yoganandasp15/Spatial-accoustic-project/hardware_photos/components_closeup_classic_esp32.jpg

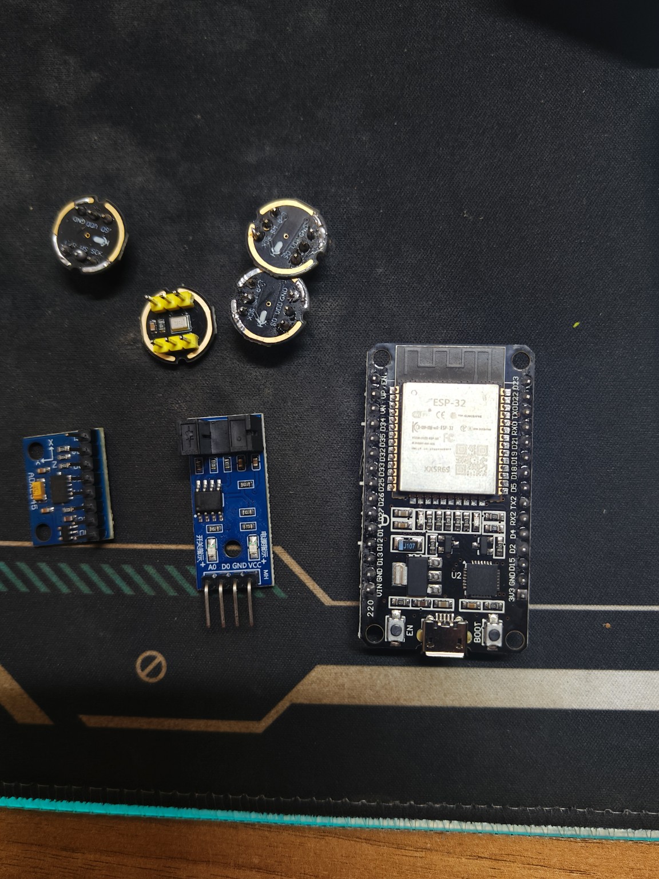
hardware_photos/components_closeup_classic_esp32.jpg
