yoganandasp15/Spatial-accoustic-project/hardware_photos/components_overview.jpg

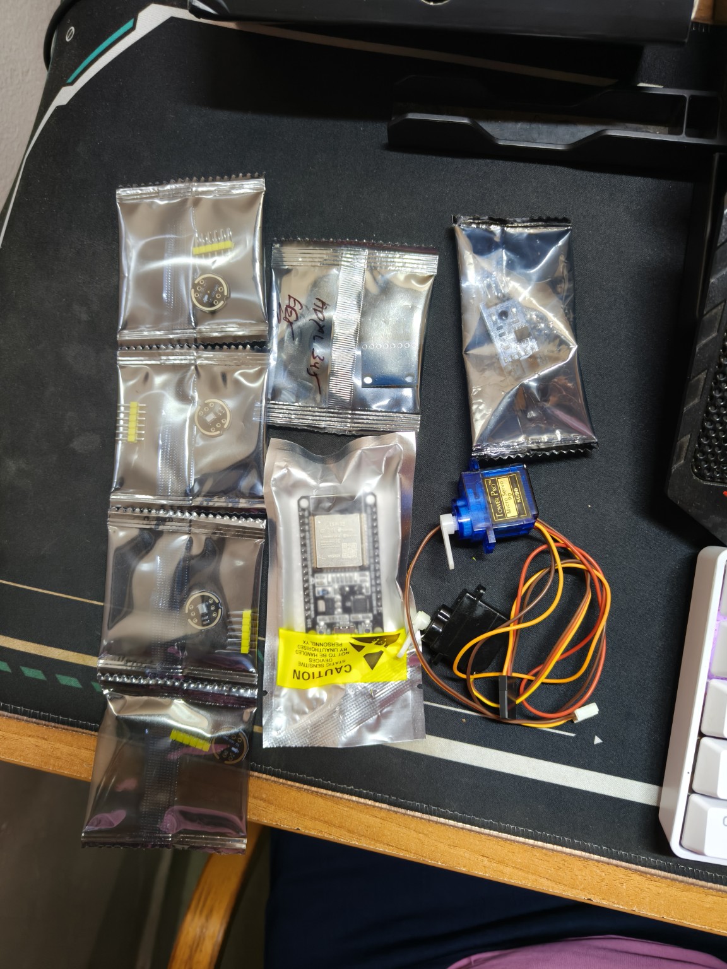
hardware_photos/components_overview.jpg
