yoganandasp15/Spatial-accoustic-project/docs/daily_logs/2026-11-07_minor_project_reconciliation.md

# Engineering Daily Log — 7 November 2026

**Milestone:** ECE Minor Project Evaluation & AI Peer Review Reconciliation  
**Engineers:** Yogi & Antigravity CLI  

---

## 1. Summary of Activities
1. **GitHub Repository Inspection & Audit:**
   - Completed initial repository staging and push to `https://github.com/yoganandasp15/Spatial-accoustic-project.git`.
   - Ingested external AI peer review feedback from ChatGPT via connected repository integration.
   - Audited all 6 critical points raised by ChatGPT across firmware, GUI, and academic documentation.
2. **Firmware Alignment (`ESP32_Spatial_Acoustic_Radar_Firmware.ino`):**
   - Corrected audio sample bit-shift from `>> 14` to `>> 16` for standard MSB-aligned signed 16-bit PCM unpacking.
   - Documented hardware clocking invariants: shared SCK (GPIO 18) and WS (GPIO 21) guarantee 0 PPM sampling frequency drift between I2S0 (Master) and I2S1 (Slave).
   - Clarified DMA buffer block alignment within 128-frame DMA blocks.
3. **GUI Application Enhancements (`spatial_acoustic_radar_pro.py`):**
   - Implemented dynamic **Evidence Mode Tag** in HUD and main figure banner (`[MODE: LIVE 4-MIC ULA PHYSICAL HARDWARE (COM8)]`, `[MODE: SYNTHETIC 4-CH ARRAY SIMULATION]`, `[MODE: LAPTOP INTERNAL MIC DEMO]`).
   - Refined 2D Heatmap title to explicitly reflect 1D ULA Direction of Arrival (DOA bearing $\theta$) radial backprojection.
   - Standardized ISO 10816 labeling to "ISO 10816-Inspired Dynamic Vibration Index (g)" across all classifier outputs and telemetry text.
4. **Academic Documentation & Report Refinements:**
   - Updated `README.md`, `docs/PROJECT_STATUS.md`, `docs/HARDWARE_STATUS.md`, and `MINOR_PROJECT_FINAL_REPORT.md`.
   - Established 4 rigorous academic evidence tiers:
     * Tier 1: Machine fault ground truth (MAFAULDA 10g unbalance $1\times$ order surge & CWRU bearing dataset).
     * Tier 2: Super-resolution acoustic localization simulation proof ($0.34^\circ$ median error across 25 off-grid test points).
     * Tier 3: Classic ESP32 physical embedded prototype (11,025 Hz 4-ch DMA streaming on COM8 @ 921,600 baud).
     * Tier 4: Live interactive multimodal GUI with Golden Baseline differential engine.
   - Created `docs/reviews/chatgpt/2026-11-07_chatgpt_audit_and_reconciliation.md`.

---

## 2. Verification Results
* `py_compile` on `spatial_acoustic_radar_pro.py`: **Exit code 0 (Pass)**.
* Git repository status: All changes staged and tracked cleanly.
