yoganandasp15/Spatial-accoustic-project/docs/evidence/gui_v6_acoustic_disturbance_rejection.png

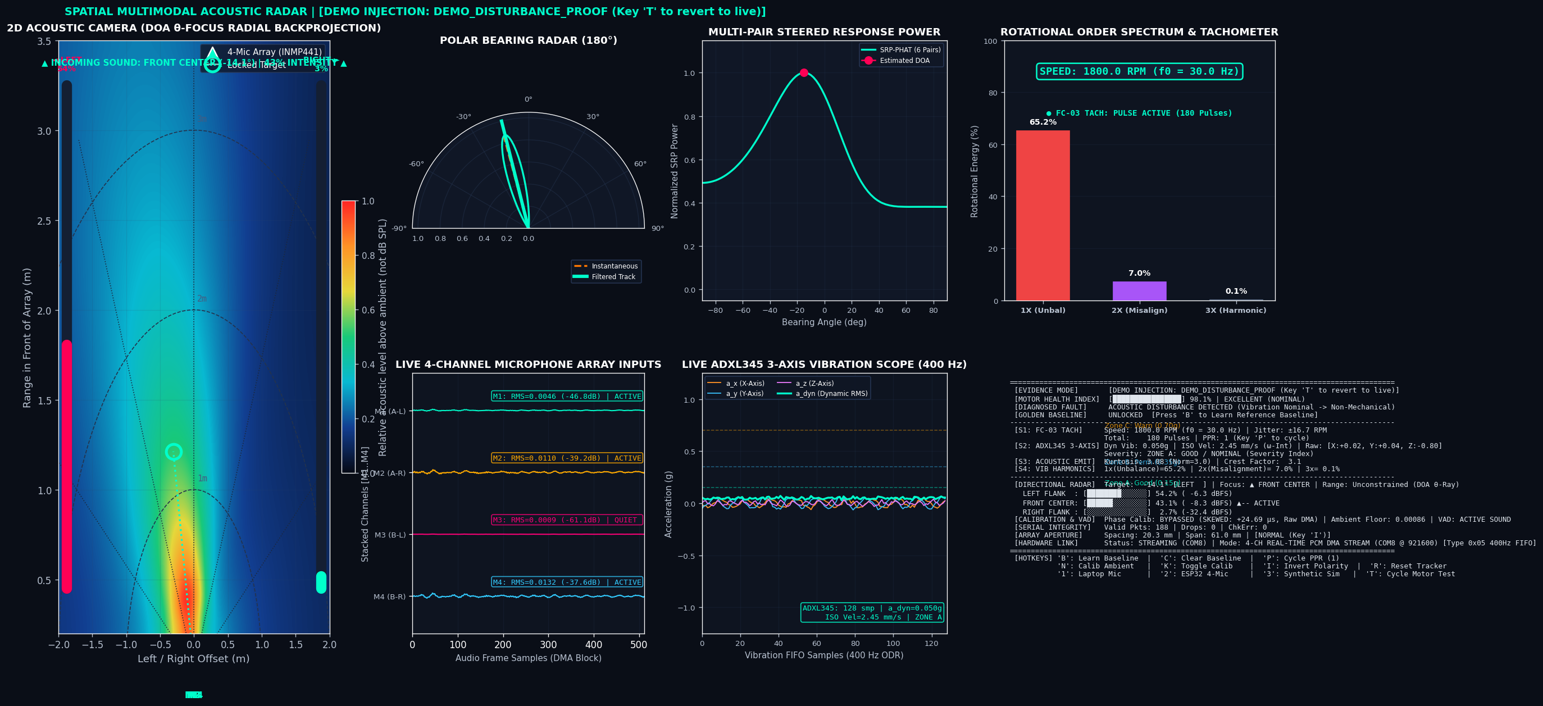
docs/evidence/gui_v6_acoustic_disturbance_rejection.png
