yoganandasp15/Spatial-accoustic-project/docs/evidence/gui_v6_healthy_motor_showcase.png

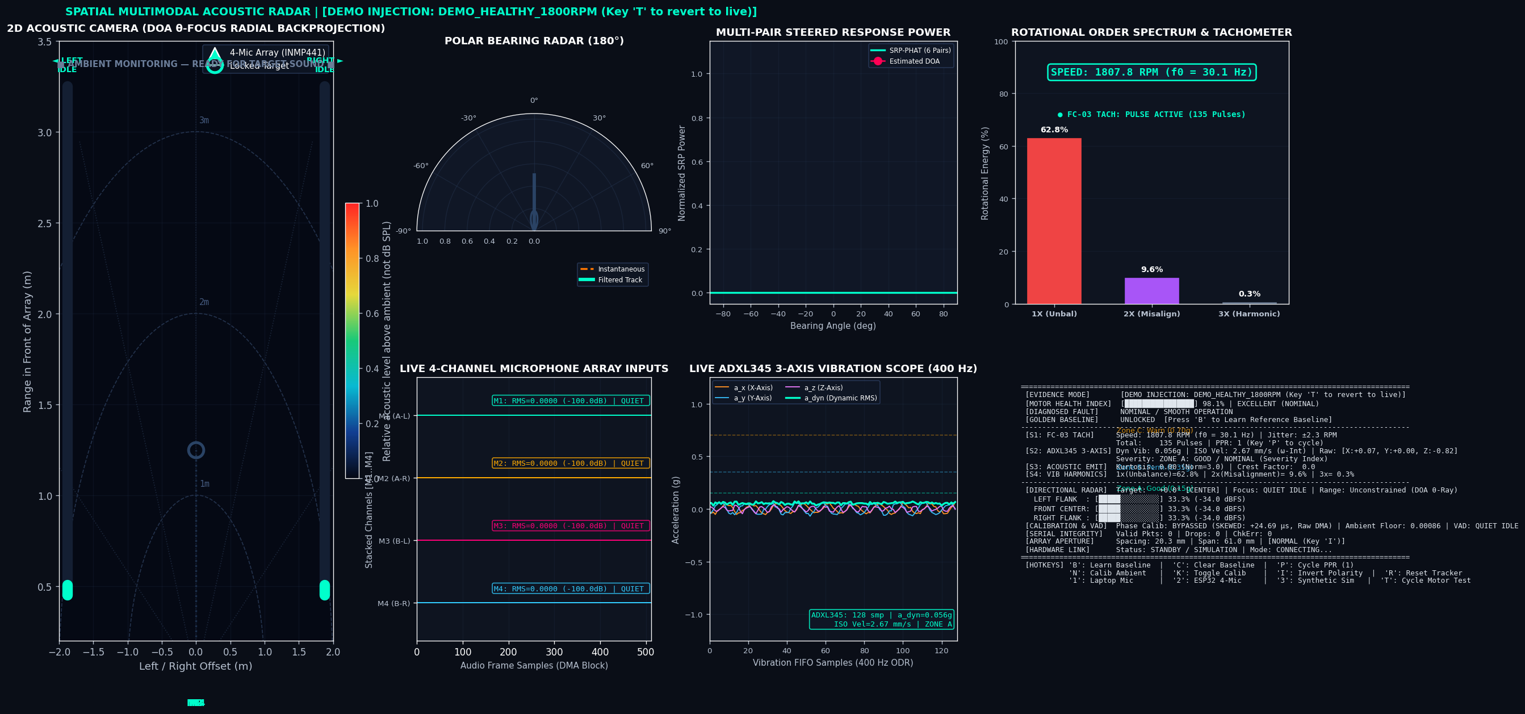
docs/evidence/gui_v6_healthy_motor_showcase.png
