yoganandasp15/Spatial-accoustic-project/docs/evidence/gui_v6_mass_unbalance_showcase.png

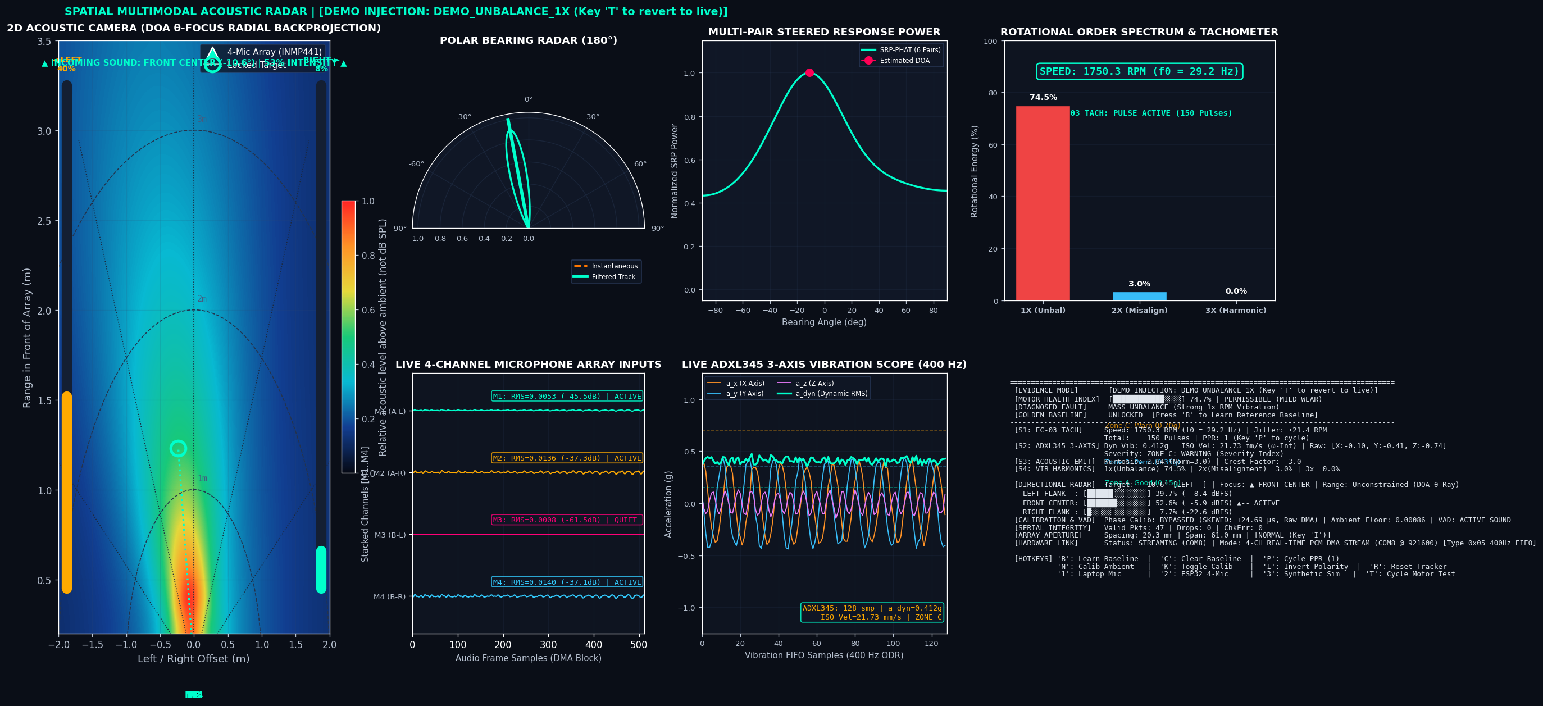
docs/evidence/gui_v6_mass_unbalance_showcase.png
