yoganandasp15/Spatial-accoustic-project/stage2_acoustic_localization/evidence/dual_i2s_phase_skew_audit.png

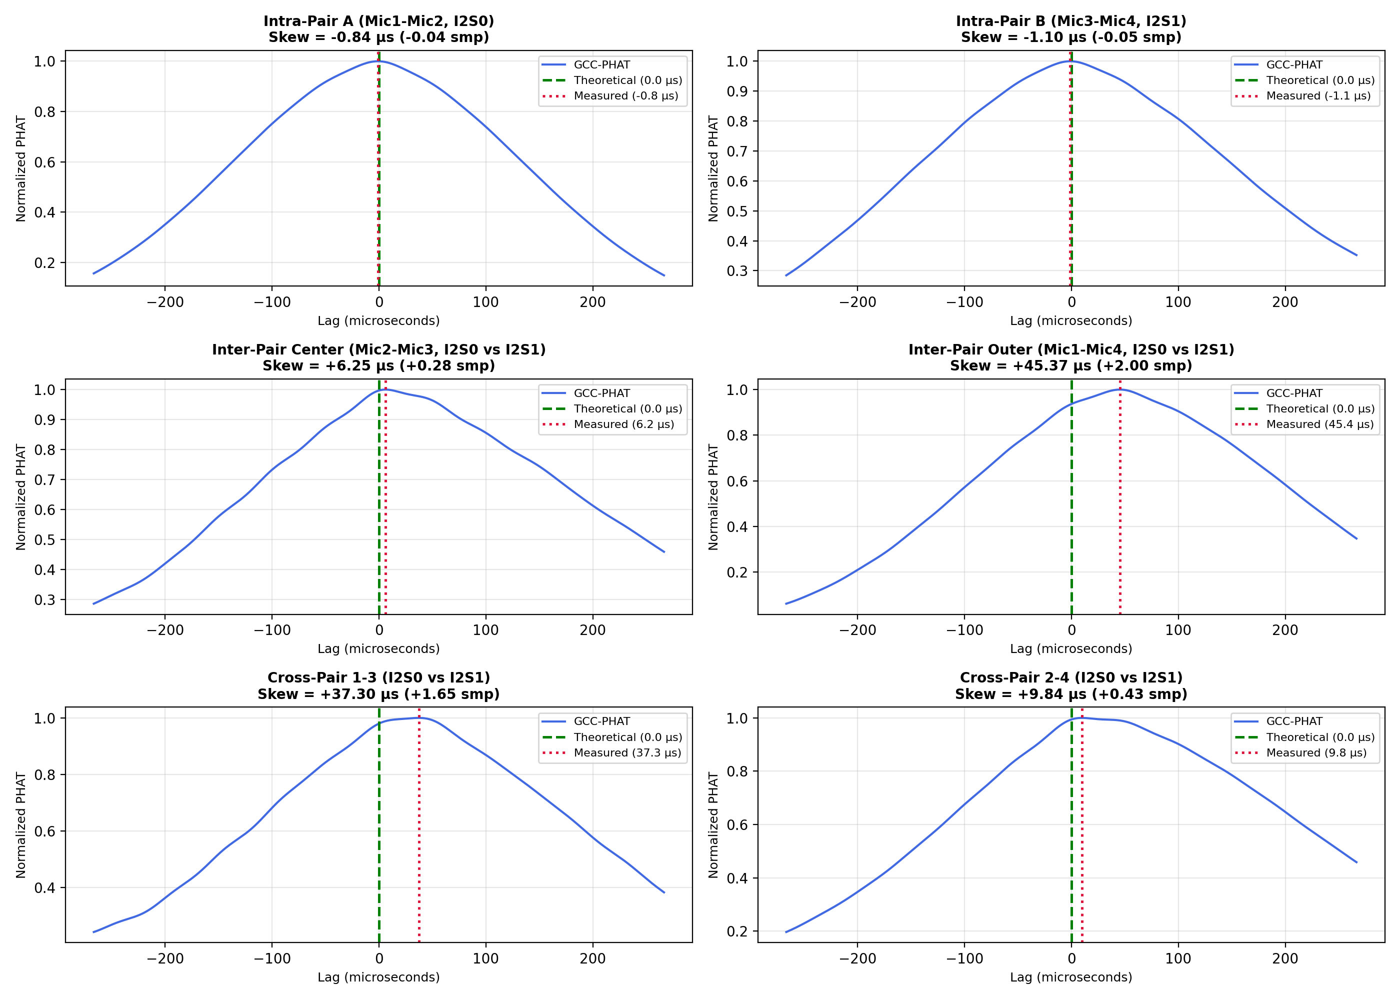
stage2_acoustic_localization/evidence/dual_i2s_phase_skew_audit.png
