yoganandasp15/Spatial-accoustic-project/stage2_acoustic_localization/evidence/stage2/stage2_srp_heatmaps_sample.png

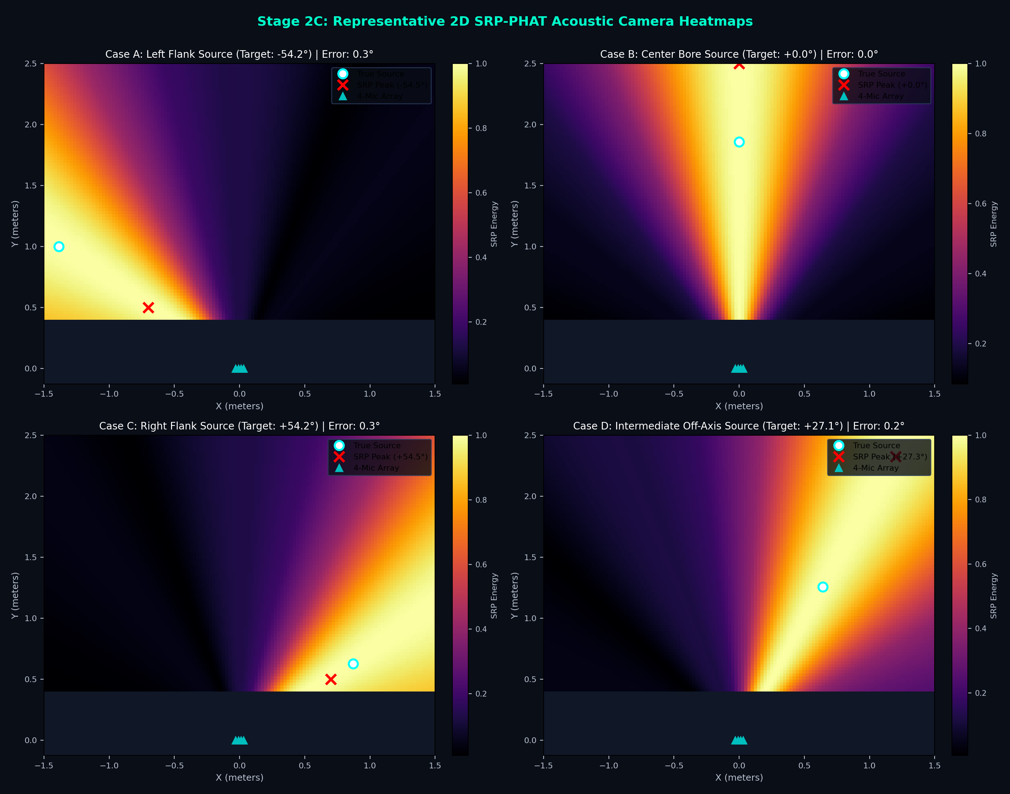
stage2_acoustic_localization/evidence/stage2/stage2_srp_heatmaps_sample.png
