yoganandasp15/Spatial-accoustic-project/stage4_realtime_fusion_radar/evidence/offline_multimodal_diagnostic_report.png

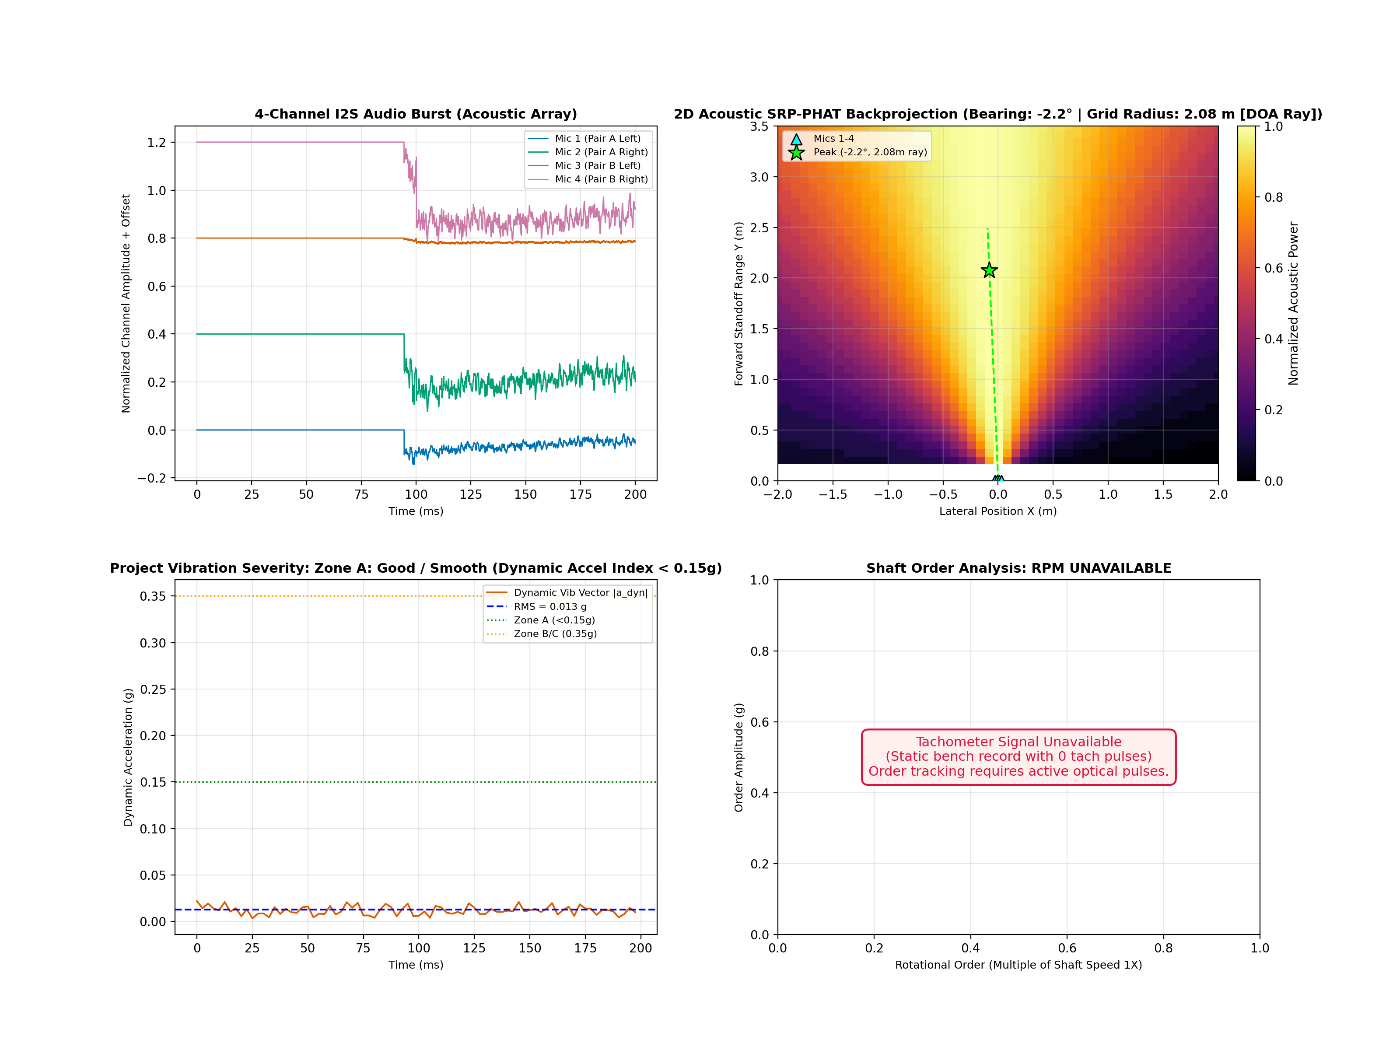
stage4_realtime_fusion_radar/evidence/offline_multimodal_diagnostic_report.png
