yoganandasp15/Spatial-accoustic-project/stage1_vibration_and_tachometer/evidence/order_tracking_spectrum.png

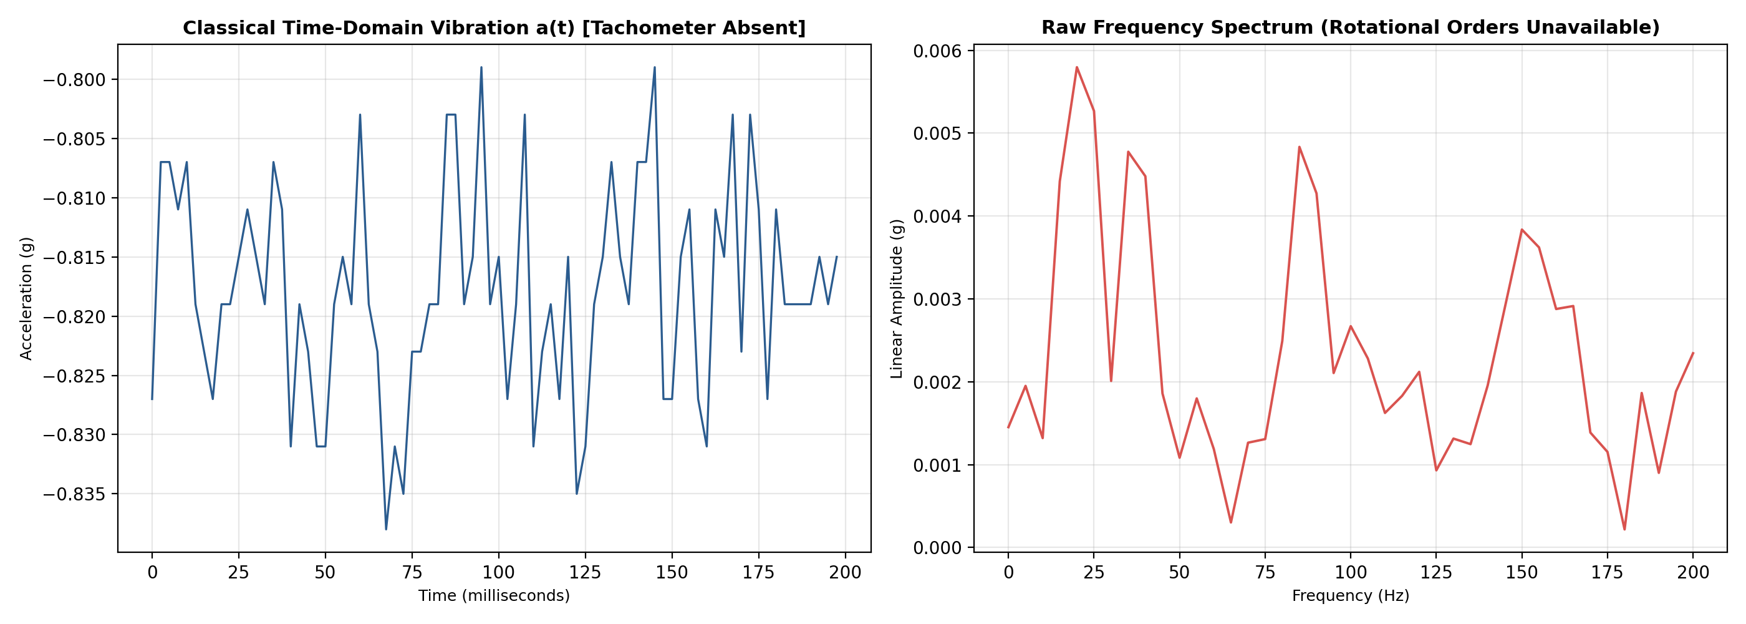
stage1_vibration_and_tachometer/evidence/order_tracking_spectrum.png
