yoganandasp15/Spatial-accoustic-project/docs/4MIC_WIRING_CLASSIC_ESP32.png

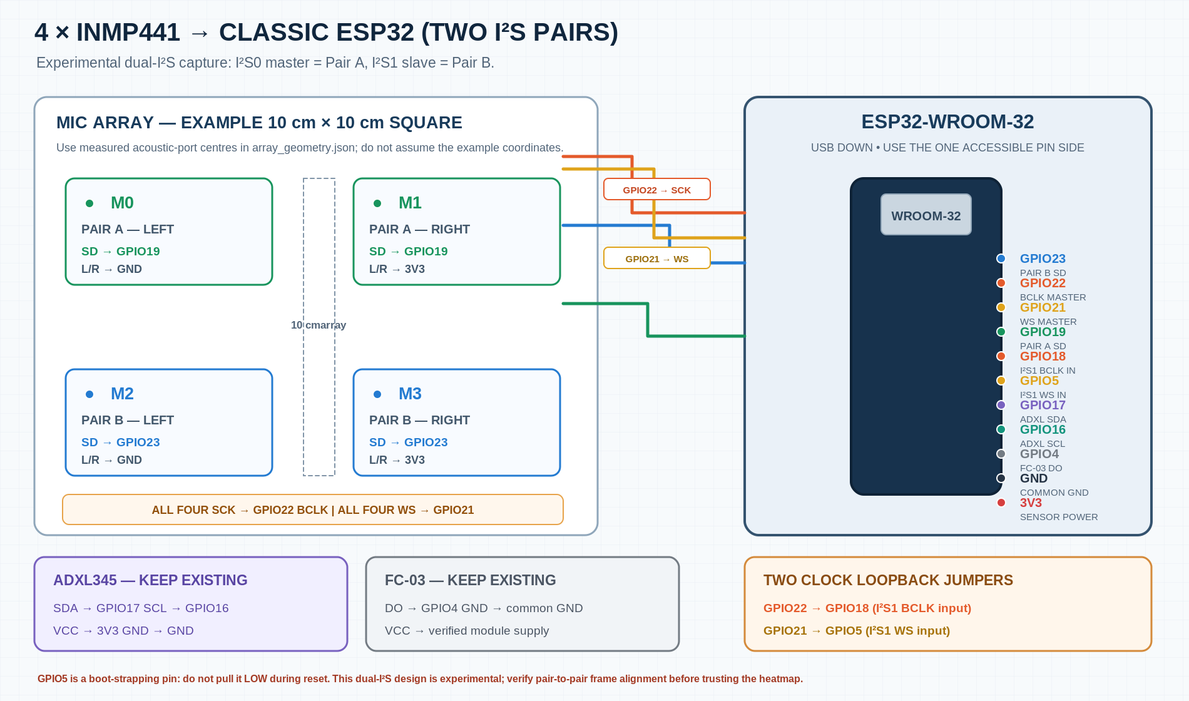
docs/4MIC_WIRING_CLASSIC_ESP32.png
