yoganandasp15/Spatial-accoustic-project/hardware_photos/reference_wiring_style.png

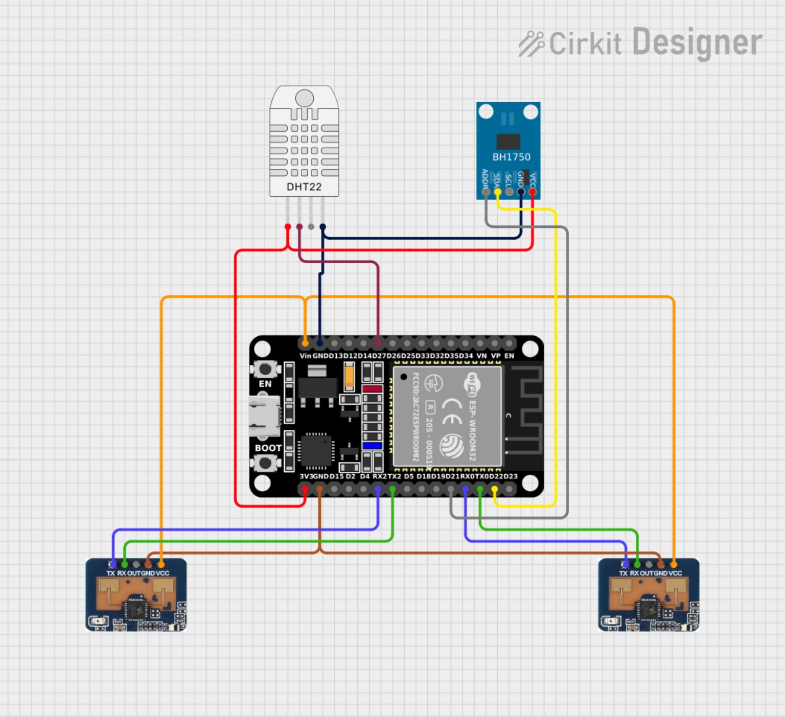
hardware_photos/reference_wiring_style.png
