yoganandasp15/Spatial-accoustic-project/stage2_acoustic_localization/evidence/stage2/stage2_localization_benchmarks.csv

test_id | true_x_m | true_y_m | true_range_m | true_angle_deg | est_x_m | est_y_m | est_angle_deg | angle_error_deg | dist_error_m | confidence
1 | -1.0813 | 0.5042 | 1.1931 | -65.00 | -1.3000 | 0.6250 | -64.32 | 0.68 | 0.2498 | 2.57
2 | -1.7493 | 1.0270 | 2.0285 | -59.58 | -1.4250 | 0.8500 | -59.18 | 0.40 | 0.3695 | 2.37
3 | -1.3875 | 1.0019 | 1.7114 | -54.17 | -0.7000 | 0.5000 | -54.46 | 0.30 | 0.8512 | 2.16
4 | -1.1413 | 1.0009 | 1.5181 | -48.75 | -1.3500 | 1.2000 | -48.37 | 0.38 | 0.2884 | 1.92
5 | -0.6013 | 0.6373 | 0.8762 | -43.33 | -0.8500 | 0.8750 | -44.17 | 0.84 | 0.3440 | 1.83
6 | -0.5384 | 0.6912 | 0.8762 | -37.92 | -0.4500 | 0.5750 | -38.05 | 0.13 | 0.1460 | 1.71
7 | -0.3945 | 0.6192 | 0.7342 | -32.50 | -1.5000 | 2.4000 | -32.01 | 0.49 | 2.0960 | 1.65
8 | -0.8678 | 1.6970 | 1.9060 | -27.08 | -1.2250 | 2.3750 | -27.28 | 0.20 | 0.7664 | 1.65
9 | -0.5618 | 1.4141 | 1.5216 | -21.67 | -0.9250 | 2.3500 | -21.49 | 0.18 | 1.0039 | 1.67
10 | -0.4692 | 1.6097 | 1.6767 | -16.25 | -0.2750 | 0.9250 | -16.56 | 0.31 | 0.7117 | 1.73
11 | -0.1278 | 0.6677 | 0.6798 | -10.83 | -0.1250 | 0.6750 | -10.49 | 0.34 | 0.0078 | 1.82
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
