yoganandasp15/Spatial-accoustic-project/data/experiments/motor_defective_run.csv

sample_idx | host_time_s | accel_x_g | accel_y_g | accel_z_g | dyn_x_g | dyn_y_g | dyn_z_g | dyn_mag_g | tach_pulses | instant_rpm
0 | 0.009767 | -0.0390 | 0.0150 | -0.7800 | -0.0370 | 0.0142 | 0.0380 | 0.0550 | 783 | 0.0
1 | 0.012267 | -0.0270 | 0.0150 | -0.7640 | -0.0238 | 0.0135 | 0.0513 | 0.0581 | 783 | 0.0
2 | 0.014767 | -0.0190 | 0.0150 | -0.7640 | -0.0150 | 0.0129 | 0.0487 | 0.0526 | 783 | 0.0
3 | 0.017267 | -0.0350 | 0.0150 | -0.7760 | -0.0295 | 0.0122 | 0.0349 | 0.0473 | 783 | 0.0
4 | 0.019767 | -0.0390 | 0.0110 | -0.7800 | -0.0318 | 0.0078 | 0.0294 | 0.0440 | 783 | 0.0
5 | 0.021549 | -0.0270 | 0.0150 | -0.7870 | -0.0188 | 0.0112 | 0.0212 | 0.0305 | 783 | 0.0
6 | 0.024049 | -0.0460 | 0.0310 | -0.7520 | -0.0359 | 0.0259 | 0.0534 | 0.0694 | 783 | 0.0
7 | 0.026549 | -0.0350 | 0.0310 | -0.7680 | -0.0237 | 0.0246 | 0.0356 | 0.0493 | 783 | 0.0
8 | 0.029049 | -0.0270 | 0.0190 | -0.7800 | -0.0149 | 0.0119 | 0.0224 | 0.0294 | 783 | 0.0
9 | 0.031549 | -0.0350 | 0.0230 | -0.7800 | -0.0217 | 0.0151 | 0.0213 | 0.0340 | 783 | 0.0
10 | 0.033234 | -0.0350 | 0.0150 | -0.7800 | -0.0206 | 0.0068 | 0.0202 | 0.0297 | 783 | 0.0
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
