yoganandasp15/Spatial-accoustic-project/data/experiments/motor_healthy_run.csv

sample_idx | host_time_s | accel_x_g | accel_y_g | accel_z_g | dyn_x_g | dyn_y_g | dyn_z_g | dyn_mag_g | tach_pulses | instant_rpm
0 | 0.008305 | -0.0420 | 0.0000 | -0.7800 | -0.0399 | 0.0000 | 0.0380 | 0.0551 | 12 | 0.0
1 | 0.010805 | -0.0230 | 0.0150 | -0.7680 | -0.0199 | 0.0142 | 0.0475 | 0.0534 | 12 | 0.0
2 | 0.013305 | -0.0230 | 0.0110 | -0.7560 | -0.0189 | 0.0097 | 0.0565 | 0.0604 | 12 | 0.0
3 | 0.015805 | -0.0270 | 0.0030 | -0.7760 | -0.0217 | 0.0017 | 0.0347 | 0.0410 | 12 | 0.0
4 | 0.018305 | -0.0270 | 0.0030 | -0.7760 | -0.0206 | 0.0016 | 0.0330 | 0.0389 | 12 | 0.0
5 | 0.021969 | -0.0350 | 0.0000 | -0.7760 | -0.0272 | -0.0014 | 0.0313 | 0.0415 | 12 | 0.0
6 | 0.024469 | -0.0350 | 0.0030 | -0.7800 | -0.0258 | 0.0016 | 0.0259 | 0.0367 | 12 | 0.0
7 | 0.026969 | -0.0270 | 0.0110 | -0.7560 | -0.0169 | 0.0091 | 0.0475 | 0.0512 | 12 | 0.0
8 | 0.029469 | -0.0230 | 0.0110 | -0.7640 | -0.0123 | 0.0086 | 0.0375 | 0.0404 | 12 | 0.0
9 | 0.031969 | -0.0390 | 0.0000 | -0.7680 | -0.0269 | -0.0023 | 0.0318 | 0.0417 | 12 | 0.0
10 | 0.034689 | -0.0310 | 0.0000 | -0.7720 | -0.0179 | -0.0021 | 0.0264 | 0.0320 | 12 | 0.0
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
