yoganandasp15/Spatial-accoustic-project/stage2_acoustic_localization/evidence/stage2/stage2_tdoa_gcc_phat_verification.png

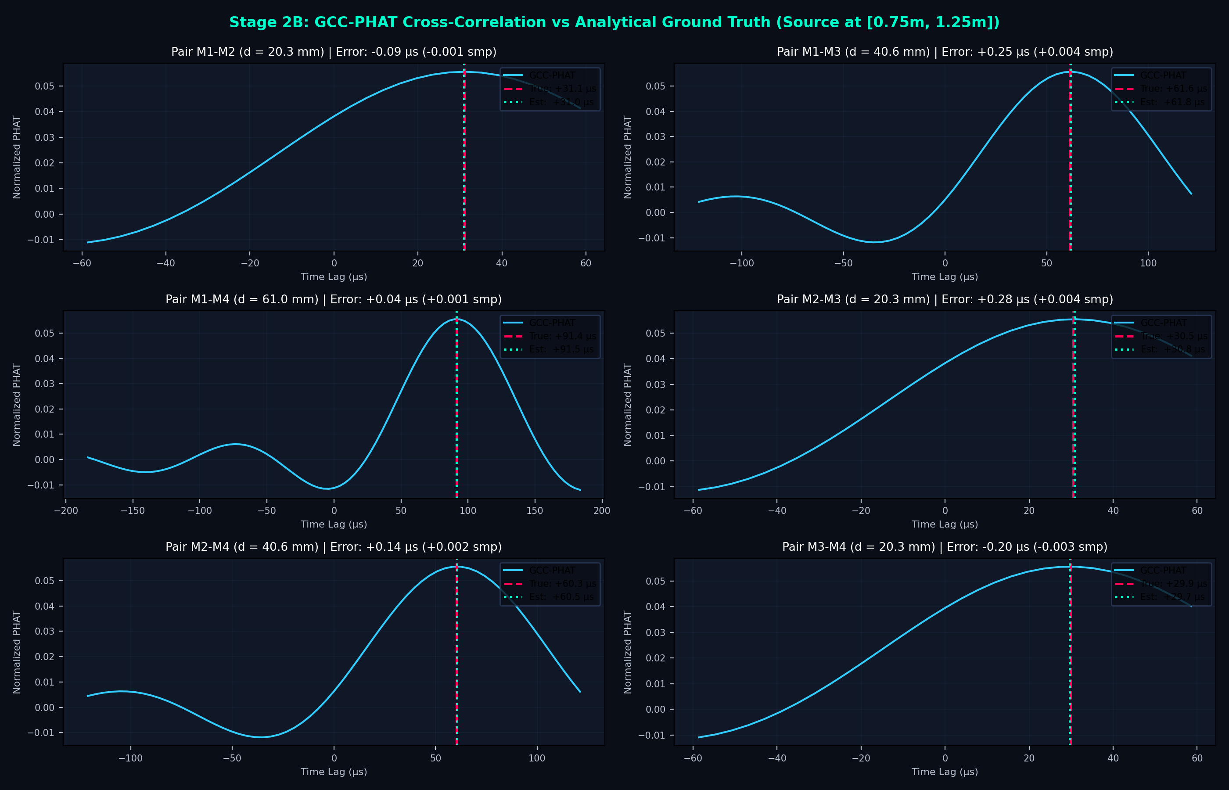
stage2_acoustic_localization/evidence/stage2/stage2_tdoa_gcc_phat_verification.png
