yoganandasp15/Spatial-accoustic-project/stage4_realtime_fusion_radar/src/spatial_acoustic_radar_pro.py

"""
=============================================================================
SPATIAL MULTIMODAL ACOUSTIC RADAR & FAULT LOCALIZATION ENGINE (PRO V6)
=============================================================================
Industrial-Grade 4-Microphone Acoustic Camera & Multimodal Telemetry Suite
Integrated for ESP32 Dual-I2S Master/Slave Array + ADXL345 + FC-03 Tachometer

Features:
  1. Full 4-Microphone Uniform Linear Array (ULA) Support:
     - Mic 1: Pair A Left  (GPIO 19, Row 20) -> x = -30.48 mm
     - Mic 2: Pair A Right (GPIO 19, Row 28) -> x = -10.16 mm
     - Mic 3: Pair B Left  (GPIO 23, Row 36) -> x = +10.16 mm
     - Mic 4: Pair B Right (GPIO 23, Row 44) -> x = +30.48 mm
  2. Multi-Pair Steered Response Power (SRP-PHAT) with 6 acoustic baseline pairs.
  3. Live 4-Channel Input Oscilloscope & Dynamic VU Meters (Color-Coded).
  4. Real-time ADXL345 3-Axis Vibration Gauges & ISO 10816 Severity Indicator.
  5. FC-03 Optical Tachometer Shaft RPM & Pulse Monitor.
  6. Real-Time Rotating Machinery Acoustic Fault Classifier.
  7. Dual-Mode Hardware Ingestion (Binary 4-CH PCM + Live ASCII Telemetry + Auto-Demo Fallback).
=============================================================================
"""

import collections
import json
import math
import os
import struct
import sys
import threading
import time
from typing import Any, Dict, List, Optional, Tuple, Union

import matplotlib
# Force Qt backend explicitly (most reliable for key events on Windows)
matplotlib.use("QtAgg")
import matplotlib.gridspec as gridspec
import matplotlib.pyplot as plt

# ── Clear ALL default matplotlib keybindings that steal our keys ──────────────
# Without this, matplotlib eats: b(back), g(grid), k(log), l(log), p(pan),
# r(home), s(save), q(quit), c, f, h, i, L, n, t, space, etc.
_STEAL_KEYS = [
    "keymap.back", "keymap.forward", "keymap.fullscreen", "keymap.grid",
    "keymap.grid_minor", "keymap.home", "keymap.pan", "keymap.quit",
    "keymap.quit_all", "keymap.save", "keymap.xscale", "keymap.yscale",
    "keymap.zoom", "keymap.copy",
]
for _k in _STEAL_KEYS:
    try:
        plt.rcParams[_k] = []
    except KeyError:
        pass
# ─────────────────────────────────────────────────────────────────────────────

import numpy as np
import sounddevice as sd
from matplotlib.animation import FuncAnimation
from matplotlib.colors import LinearSegmentedColormap
from scipy import signal
from scipy.ndimage import gaussian_filter
from scipy.fft import irfft, rfft
from scipy.signal import welch
from scipy.stats import kurtosis

try:
    import serial
    import serial.tools.list_ports
    SERIAL_AVAILABLE = True
except ImportError:
    SERIAL_AVAILABLE = False


# =============================================================================
# GLOBAL SYSTEM CONSTANTS & CONFIGURATION
# =============================================================================
SPEED_OF_SOUND = 343.0  # Dry air at 20°C (m/s)

# Spatial Heatmap Grid Boundary
X_MIN, X_MAX = -2.0, 2.0   # Left / Right (meters)
Y_MIN, Y_MAX =  0.2, 3.5   # Range in front of array (meters)
GRID_X = 51
GRID_Y = 45

# Acoustic Filter Bounds (Hz) - DC Motor & Voice Bandwidth (Admit rotational fundamentals & harmonics)
FREQ_MIN = 45.0
FREQ_MAX = 5500.0

# Fixed palette: blue/cyan/green/yellow/orange/red. Relative digital level, not dB SPL.
ACOUSTIC_HEAT_CMAP = LinearSegmentedColormap.from_list(
    "acoustic_thermal",
    ["#050914", "#123e91", "#08b9d2", "#18c979", "#e5d83b", "#ff9226", "#ff2424"], N=256
)

# Frame & Animation Timing
UPDATE_INTERVAL_MS = 50     # 20 FPS GUI refresh

# Preliminary Empirical Sensitivity Calibration Factors (Controlled-tone experiment relative to MIC3=1.00)
# MIC1=1.09, MIC2=2.47 (weak mic analog compensation), MIC3=1.00, MIC4=1.41
# Applied exclusively to floating-point amplitude analysis (VU meters, flank energy balance).
# Raw audio passed to GCC-PHAT / SRP-PHAT remains unscaled to prevent artificial noise inflation.
PRELIM_MIC_SENSITIVITY_GAINS = np.array([1.09, 2.47, 1.00, 1.41], dtype=np.float32)
HEATMAP_SMOOTH_ALPHA = 0.30  # Surface temporal smoothing


def apply_pair_phase_compensation(
    audio_4ch: np.ndarray,
    fs: float,
    comp_delay_sec: float
) -> np.ndarray:
    """
    Applies exact frequency-domain fractional delay phase compensation to Pair B (channels 2 & 3):
    H(f) = exp(-j * 2 * pi * f * comp_delay_sec)
    Uses symmetric edge-padding to eliminate boundary step transients.
    """
    if abs(comp_delay_sec) < 1e-12 or audio_4ch.shape[1] < 4:
        return audio_4ch.copy()
        
    n_samples, n_channels = audio_4ch.shape
    n_pad = 128
    n_fft = n_samples + 2 * n_pad
    freqs = np.fft.rfftfreq(n_fft, d=1.0 / fs)
    phase_shift = np.exp(-2j * np.pi * freqs * comp_delay_sec)
    
    aligned = audio_4ch.copy()
    for ch in [2, 3]:
        if ch < n_channels:
            padded = np.pad(audio_4ch[:, ch], (n_pad, n_pad), mode="edge")
            ch_fft = np.fft.rfft(padded, n=n_fft)
            compensated = np.fft.irfft(ch_fft * phase_shift, n=n_fft)
            aligned[:, ch] = compensated[n_pad : n_pad + n_samples]
            
    return aligned


# =============================================================================
# DYNAMIC TARGET-LOCK STATE-SPACE TRACKER
# =============================================================================
class DynamicTargetTracker:
    """Adaptive Target-Lock Tracker with fast re-acquisition and smooth slew."""

    def __init__(self, alpha: float = 0.40, gate_deg: float = 30.0):
        self.alpha = alpha
        self.gate_deg = gate_deg
        self.tracked_angle = 0.0
        self.tracked_range = 1.25
        self.confidence = 0.0
        self.locked = False
        self.pending_angle = 0.0
        self.pending_count = 0
        self.last_valid_time = time.time()

    def reset(self):
        self.tracked_angle = 0.0
        self.tracked_range = 1.25
        self.confidence = 0.0
        self.locked = False
        self.pending_count = 0

    def update(
        self,
        meas_angle: float,
        meas_prom: float,
        is_active_sound: bool,
        nominal_range: float = 1.25
    ) -> Tuple[float, float, float, bool]:
        now = time.time()

        if not is_active_sound or meas_prom < 0.50:
            dt_silence = now - self.last_valid_time
            self.confidence *= 0.85
            if dt_silence > 0.25:
                self.locked = False
            return self.tracked_angle, self.tracked_range, self.confidence, False

        self.last_valid_time = now
        meas_conf_pct = min(99.0, max(30.0, meas_prom * 50.0))

        if not self.locked:
            self.tracked_angle = meas_angle
            self.tracked_range = nominal_range
            self.confidence = meas_conf_pct
            self.locked = True
            self.pending_count = 0
        else:
            diff = meas_angle - self.tracked_angle
            # Normalize angle difference to [-180, 180]
            diff = (diff + 180.0) % 360.0 - 180.0
            if abs(diff) <= self.gate_deg:
                self.tracked_angle += self.alpha * diff
                self.tracked_range = 0.85 * self.tracked_range + 0.15 * nominal_range
                self.confidence = (1.0 - self.alpha) * self.confidence + self.alpha * meas_conf_pct
                self.pending_count = 0
            else:
                # Fast re-acquisition when sound moves across sectors
                if meas_prom > 0.80:
                    self.tracked_angle = 0.25 * self.tracked_angle + 0.75 * meas_angle
                    self.confidence = meas_conf_pct
                    self.pending_count = 0
                else:
                    self.pending_angle = meas_angle
                    self.pending_count += 1
                    if self.pending_count >= 3:
                        self.tracked_angle = meas_angle
                        self.confidence = meas_conf_pct
                        self.pending_count = 0

        return self.tracked_angle, self.tracked_range, self.confidence, self.locked


# =============================================================================
# ACOUSTIC ACTIVITY DETECTOR (SCHMITT-TRIGGER VAD WITH NOISE FLOOR FREEZE)
# =============================================================================
class AcousticActivityDetector:
    """
    Production Dual-Threshold Schmitt-Trigger Voice/Acoustic Activity Detector (VAD).
    Features:
      1. Initial ambient quiet-room baseline calibration (median of quiet frames).
      2. Hangover smoothing to bridge speech/acoustic word pauses without flutter.
      3. Strict Noise Floor Adaptation Freeze: during active acoustic sound, the
         ambient floor is 100% frozen, preventing loud sound from absorbing into baseline.
      4. Downward baseline tracking during confirmed quiet intervals (>0.60s post-sound).
    """

    def __init__(
        self,
        min_active_threshold: float = 0.0035,
        calib_frames: int = 25,
        hangover_sec: float = 0.350
    ):
        self.min_active_threshold = min_active_threshold
        self.calib_frames = calib_frames
        self.hangover_sec = hangover_sec
        self.noise_floor = 0.0030
        self.calib_samples: List[float] = []
        self.is_calibrating = True
        self.last_active_time = 0.0

    def start_calibration(self):
        """Clears existing sample history and restarts ambient noise floor calibration."""
        self.calib_samples.clear()
        self.is_calibrating = True

    def note_coherent_source(self, current_time: float):
        """Recover when SRP proves a coherent source was present during startup."""
        self.is_calibrating = False
        self.calib_samples.clear()
        self.noise_floor = min(max(0.0008, self.noise_floor), 0.0030)
        self.min_active_threshold = max(0.0025, self.noise_floor * 1.60)
        self.last_active_time = current_time

    def process_frame(self, avg_rms: float, current_time: float) -> Tuple[bool, float, float]:
        """
        Evaluates incoming audio frame energy against dynamic Schmitt thresholds.
        Returns:
            is_active: Whether sound activity is detected in this frame
            noise_floor: Current estimated ambient floor RMS
            attack_thresh: Active sound attack threshold
        """
        # Phase 1: Ambient baseline calibration
        if self.is_calibrating:
            self.calib_samples.append(avg_rms)
            if len(self.calib_samples) >= self.calib_frames:
                # Lower quantile is less sensitive to brief target sound during startup.
                self.noise_floor = max(0.0008, float(np.percentile(self.calib_samples, 20)))
                self.min_active_threshold = max(0.0025, self.noise_floor * 1.60)
                self.is_calibrating = False

        # Phase 2: Dual-threshold Schmitt Trigger with Hangover
        attack_thresh = max(self.min_active_threshold, self.noise_floor * 1.60)
        release_thresh = max(0.0020, self.noise_floor * 1.25)

        if avg_rms >= attack_thresh:
            self.last_active_time = current_time
            is_active = True
        elif (current_time - self.last_active_time) < self.hangover_sec:
            is_active = bool(avg_rms >= release_thresh)
        else:
            is_active = False

        # Phase 3: Noise floor adaptation rules (frozen during sound; tracks quiet intervals)
        if not is_active and (current_time - self.last_active_time) > 0.60:
            if avg_rms < self.noise_floor:
                self.noise_floor = 0.92 * self.noise_floor + 0.08 * avg_rms
            elif avg_rms < self.noise_floor * 1.30:
                self.noise_floor = 0.995 * self.noise_floor + 0.005 * avg_rms

        return is_active, self.noise_floor, attack_thresh


# =============================================================================
# SCALABLE ARRAY GEOMETRY (4-MIC ULA & 2-MIC PRESETS)
# =============================================================================
class ArrayGeometry:
    """Manages physical microphone coordinates and precomputes spatial delay manifolds."""

    def __init__(self, name: str, mic_coords: np.ndarray, description: str = ""):
        self.name = name
        self.mic_coords = np.asarray(mic_coords, dtype=np.float64)
        self.num_mics = len(mic_coords)
        self.description = description

        self.pairs: List[Tuple[int, int]] = [
            (i, j) for i in range(self.num_mics) for j in range(i + 1, self.num_mics)
        ]
        self.num_pairs = len(self.pairs)

        # Baseline spacing between reference pair (0, 1)
        self.baseline_m = float(np.linalg.norm(self.mic_coords[0] - self.mic_coords[1]))

        # 2D Cartesian Grid
        self.xs = np.linspace(X_MIN, X_MAX, GRID_X)
        self.ys = np.linspace(Y_MIN, Y_MAX, GRID_Y)
        self.xx, self.yy = np.meshgrid(self.xs, self.ys)

        self.pair_delays = self._precompute_delays()

    def set_baseline(self, new_baseline_m: float):
        """Live adjustment of microphone pitch."""
        pitch = max(0.010, min(0.15, new_baseline_m))
        self.baseline_m = pitch
        if self.num_mics == 4:
            # Symmetrical 4-mic linear array: [-1.5d, -0.5d, +0.5d, +1.5d]
            self.mic_coords = np.array([
                [-1.5 * pitch, 0.0],
                [-0.5 * pitch, 0.0],
                [+0.5 * pitch, 0.0],
                [+1.5 * pitch, 0.0]
            ])
            self.pair_delays = self._precompute_delays()
        elif self.num_mics == 2:
            half = pitch / 2.0
            self.mic_coords = np.array([[-half, 0.0], [half, 0.0]])
            self.pair_delays = self._precompute_delays()

    def _precompute_delays(self) -> np.ndarray:
        distances = []
        for mx, my in self.mic_coords:
            r = np.sqrt((self.xx - mx) ** 2 + (self.yy - my) ** 2)
            distances.append(r)

        delays = []
        for i, j in self.pairs:
            tau = (distances[i] - distances[j]) / SPEED_OF_SOUND
            delays.append(tau)

        return np.asarray(delays, dtype=np.float64)


PRESETS = {
    "ESP32_4MIC_LINEAR": ArrayGeometry(
        "ESP32 Quad INMP441 Linear Array (20.32mm Pitch, 60.96mm Aperture)",
        np.array([
            [-0.03048, 0.0],  # Mic 1: Pair A Left (GPIO 19, Row 20)
            [-0.01016, 0.0],  # Mic 2: Pair A Right (GPIO 19, Row 28)
            [+0.01016, 0.0],  # Mic 3: Pair B Left (GPIO 23, Row 36)
            [+0.03048, 0.0]   # Mic 4: Pair B Right (GPIO 23, Row 44)
        ]),
        "Physical 4-microphone ULA along breadboard: 6 delay pairs with high angular sharpness."
    ),
    "ESP32_2MIC": ArrayGeometry(
        "ESP32 Dual INMP441 Pair A (20.32mm Baseline)",
        np.array([[-0.01016, 0.0], [0.01016, 0.0]]),
        "Physical INMP441 breadboard pair: bearing angle [-90°, +90°]."
    ),
    "LAPTOP_DUAL": ArrayGeometry(
        "Laptop Dual Mic Array (Intel SST)",
        np.array([[-0.060, 0.0], [0.060, 0.0]]),
        "Laptop top-bezel stereo mics (12 cm baseline)."
    ),
    "ESP32_4MIC_SQUARE": ArrayGeometry(
        "4-Mic Planar Square (10x10 cm)",
        np.array([[-0.050, -0.050], [0.050, -0.050], [0.050, 0.050], [-0.050, 0.050]]),
        "4-element planar array: full 2D focal hotspot."
    )
}


# =============================================================================
# MULTI-PAIR SUPER-RESOLUTION GCC-PHAT & SRP ENGINE
# =============================================================================
class SRPPhatEngine:
    """Steered Response Power (SRP) Engine with Multi-Pair Sinc GCC-PHAT."""

    @staticmethod
    def compute_spatial_coherence(signals: np.ndarray, max_delay_samples: int = 6) -> Tuple[int, float]:
        """
        Computes scale-invariant inter-channel normalized cross-correlation across all pairs
        within physical inter-microphone propagation lag window.
        Returns:
            coherent_pairs: Count of microphone pairs exhibiting normalized cross-correlation >= 0.18
            max_rho: Maximum cross-channel correlation coefficient observed across all pairs
        """
        N, M = signals.shape
        if M < 2 or N < 16:
            return 0, 0.0
        norms = np.sqrt(np.sum(signals.astype(np.float64)**2, axis=0))
        alive_channels = [m for m in range(M) if norms[m] >= 1e-12]
        if len(alive_channels) < 2:
            return 0, 0.0
        coherent_pairs = 0
        max_rho = 0.0
        for i_idx, i in enumerate(alive_channels):
            for j in alive_channels[i_idx + 1:]:
                s1 = signals[:, i].astype(np.float64)
                s2 = signals[:, j].astype(np.float64)
                denom = norms[i] * norms[j]
                if denom < 1e-12:
                    continue
                c = np.correlate(s1, s2, mode='full') / denom
                center = N - 1
                lo = max(0, center - max_delay_samples)
                hi = min(len(c), center + max_delay_samples + 1)
                phys_c = c[lo:hi]
                if len(phys_c) > 0:
                    rho = float(np.max(phys_c))
                    if rho > max_rho:
                        max_rho = rho
                    if rho >= 0.18:
                        coherent_pairs += 1
        return coherent_pairs, max_rho

    @staticmethod
    def gcc_phat_pair(
        sig_i: np.ndarray,
        sig_j: np.ndarray,
        fs: float,
        d_ij_m: float,
        gamma: float = 0.70,
        interp_factor: int = 16,
        min_signal_rms: float = 0.0015,
        gain_i: float = 1.0,
        gain_j: float = 1.0
    ) -> Tuple[float, float, np.ndarray, np.ndarray, bool]:
        """
        Computes super-resolution sinc GCC-PHAT between microphone pair (i, j).
        Convention: sig_i is leftward (smaller x), sig_j is rightward (larger x).
        Returns:
            best_tau: Estimated delay in seconds
            prominence: SNR prominence of the correlation peak
            c_phys: Cross-correlation in physical delay window
            l_phys: Physical delay axis
            is_valid: Boolean indicating whether peak passes coherence/PSR thresholds
        """
        n = len(sig_i)
        tau_max = (d_ij_m / SPEED_OF_SOUND) * 1.08
        dummy_lags = np.linspace(-tau_max, tau_max, 3)

        # 1. Absolute Energy Gating: Reject weak background noise before normalization
        # Evaluated on sensitivity-calibrated effective RMS to prevent discarding weak microphones (e.g. MIC2)
        rms_i = float(np.sqrt(np.mean(sig_i ** 2))) * gain_i
        rms_j = float(np.sqrt(np.mean(sig_j ** 2))) * gain_j
        if rms_i < min_signal_rms or rms_j < min_signal_rms:
            return 0.0, 0.0, np.zeros(3), dummy_lags, False

        w = signal.windows.tukey(n, alpha=0.25)
        si = (sig_i - np.mean(sig_i)) * w
        sj = (sig_j - np.mean(sig_j)) * w

        std_i = float(np.std(si)) * gain_i
        std_j = float(np.std(sj)) * gain_j
        if std_i < min_signal_rms or std_j < min_signal_rms:
            return 0.0, 0.0, np.zeros(3), dummy_lags, False

        si = si / std_i
        sj = sj / std_j

        Si = rfft(si)
        Sj = rfft(sj)

        cross = Si * np.conj(Sj)
        mag = np.abs(cross)

        freqs = np.fft.rfftfreq(n, d=1.0 / fs)
        band_mask = (freqs >= FREQ_MIN) & (freqs <= min(FREQ_MAX, fs / 2.0 - 50.0))

        inband_energy = float(np.sum(mag[band_mask] ** 2))
        total_energy = float(np.sum(mag ** 2)) + 1e-20
        if inband_energy / total_energy < 0.04:
            return 0.0, 0.0, np.zeros(3), dummy_lags, False

        cross[~band_mask] = 0.0
        peak_mag = max(1e-12, float(np.max(mag ** gamma))) if len(mag) > 0 else 1.0
        denom = np.maximum(mag ** gamma, 1e-4 * peak_mag)
        cross_phat = np.where(denom > 1e-15, cross / denom, 0.0)

        n_interp = n * interp_factor
        n_freq_interp = n_interp // 2 + 1
        cross_padded = np.zeros(n_freq_interp, dtype=complex)
        cross_padded[:len(cross_phat)] = cross_phat

        corr = np.fft.fftshift(irfft(cross_padded, n=n_interp))
        dt_fine = 1.0 / (fs * interp_factor)
        lags = np.arange(-n_interp // 2, n_interp // 2) * dt_fine

        phys_mask = np.abs(lags) <= tau_max
        c_phys = corr[phys_mask]
        l_phys = lags[phys_mask]

        if len(c_phys) < 5:
            return 0.0, 0.0, c_phys, l_phys, False

        k = int(np.argmax(c_phys))
        peak_val = float(c_phys[k])
        mean_val = float(np.mean(c_phys))
        std_val = float(np.std(c_phys)) + 1e-12
        prominence = max(0.0, (peak_val - mean_val) / std_val)

        # 2. Statistical Peak Significance Test:
        # Validates that cross-correlation peak rises significantly above baseline correlation floor
        # and does not stick to the unphysical lag window boundary.
        is_valid = bool(prominence >= 0.70 and peak_val > 0.012 and 0 < k < len(c_phys) - 1)

        if k == 0 or k == len(c_phys) - 1:
            return 0.0, 0.0, c_phys, l_phys, False

        if 0 < k < len(c_phys) - 1:
            y0, y1, y2 = float(c_phys[k - 1]), float(c_phys[k]), float(c_phys[k + 1])
            denom_p = 2.0 * (y0 - 2.0 * y1 + y2)
            if abs(denom_p) > 1e-12:
                delta = (y0 - y2) / denom_p
                delta = max(-0.5, min(0.5, delta))
                best_tau = float(l_phys[k] + delta * dt_fine)
            else:
                best_tau = float(l_phys[k])
        else:
            best_tau = float(l_phys[k])

        best_tau = max(-tau_max, min(tau_max, best_tau))
        return best_tau, prominence, c_phys, l_phys, is_valid

    @classmethod
    def compute_srp_frame(
        cls,
        signals: np.ndarray,
        fs: float,
        geometry: ArrayGeometry,
        min_active_rms: float = 0.0020,
        calib_gains: Optional[np.ndarray] = None
    ) -> Tuple[float, float, np.ndarray, np.ndarray, np.ndarray, Dict[str, object]]:
        """
        Steered Response Power (SRP) bearing estimation AND True 2D Acoustic Camera Backprojection.
        Returns:
            best_bearing_deg: Estimated angle in degrees [-90°, +90°]
            composite_prominence: SNR prominence of the aggregate peak
            angles_deg: Angle grid (181 points)
            srp_norm: Normalized 1D SRP power vs angle
            raw_2d_heatmap: True 2D backprojected acoustic intensity field (GRID_Y, GRID_X)
            side_metrics: Directional power breakdown (pct_left, pct_center, pct_right, dom_side, is_valid, active_pairs)
        """
        num_mics = min(signals.shape[1], geometry.num_mics)
        angles_deg = np.linspace(-90.0, 90.0, 181)
        angles_rad = np.deg2rad(angles_deg)
        sin_angles = np.sin(angles_rad)

        srp_profile = np.zeros_like(angles_deg, dtype=np.float64)
        raw_2d_heatmap = np.zeros((GRID_Y, GRID_X), dtype=np.float64)
        pair_prominences = []

        # 1. Per-Channel Health & Signal Strength Diagnostics (Raw & Sensitivity-Calibrated)
        ch_rms = [float(np.sqrt(np.mean(signals[:, m]**2))) for m in range(num_mics)]
        ch_peak = [float(np.max(np.abs(signals[:, m]))) for m in range(num_mics)]
        gains = calib_gains if calib_gains is not None else PRELIM_MIC_SENSITIVITY_GAINS[:num_mics]
        calib_ch_rms = [ch_rms[m] * float(gains[m]) if m < len(gains) else ch_rms[m] for m in range(num_mics)]
        avg_rms = float(np.mean(ch_rms)) if ch_rms else 0.0
        avg_calib_rms = float(np.mean(calib_ch_rms)) if calib_ch_rms else avg_rms

        ch_status = []
        for m in range(num_mics):
            effective_rms = calib_ch_rms[m]
            if ch_peak[m] > 0.98:
                ch_status.append("CLIPPED")
            elif ch_rms[m] < 1e-4 and avg_rms > 0.003:
                ch_status.append("DEAD")
            elif effective_rms < min_active_rms:
                ch_status.append("QUIET")
            else:
                ch_status.append("ACTIVE")

        # Silence Gate: If overall physical acoustic energy (calibrated) is below physical threshold,
        # return an explicit QUIET state immediately. DO NOT compute SRP on noise!
        if avg_calib_rms < min_active_rms or sum(st != "DEAD" for st in ch_status) < 2:
            return (
                0.0,
                0.0,
                angles_deg,
                np.zeros_like(angles_deg),
                np.zeros((GRID_Y, GRID_X), dtype=np.float64),
                {
                    "pct_left": 33.3, "pct_center": 33.3, "pct_right": 33.3,
                    "dom_side": "NONE", "is_valid": False, "active_pairs": 0,
                    "avg_rms": avg_rms, "ch_rms": ch_rms, "calib_ch_rms": calib_ch_rms, "ch_status": ch_status,
                    "spatial_rho": 0.0, "status": "BELOW_ENERGY_GATE"
                }
            )

        # Scale-Invariant Spatial Coherence Gate:
        # Computes normalized inter-channel correlation across microphone pairs.
        # Coherent acoustic wavefronts exhibit rho >= 0.18, whereas independent noise
        # (even at high amplitude) has max rho < 0.15. Rejects independent noise 100%.
        coherent_pairs, max_spatial_rho = cls.compute_spatial_coherence(signals, max_delay_samples=6)
        if coherent_pairs < 1 and max_spatial_rho < 0.18:
            return (
                0.0,
                0.0,
                angles_deg,
                np.zeros_like(angles_deg),
                np.zeros((GRID_Y, GRID_X), dtype=np.float64),
                {
                    "pct_left": 33.3, "pct_center": 33.3, "pct_right": 33.3,
                    "dom_side": "NONE", "is_valid": False, "active_pairs": 0,
                    "avg_rms": avg_rms, "ch_rms": ch_rms, "calib_ch_rms": calib_ch_rms, "ch_status": ch_status,
                    "spatial_rho": max_spatial_rho, "status": "LOW_SPATIAL_COHERENCE"
                }
            )

        valid_pairs_count = 0
        pair_angles: List[float] = []
        active_ch_count = sum(st == "ACTIVE" for st in ch_status)

        for p_idx, (i, j) in enumerate(geometry.pairs):
            if i >= num_mics or j >= num_mics:
                continue
            if ch_status[i] in ("DEAD", "CLIPPED") or ch_status[j] in ("DEAD", "CLIPPED"):
                continue

            sig_i = signals[:, i]
            sig_j = signals[:, j]
            d_x = geometry.mic_coords[j, 0] - geometry.mic_coords[i, 0]
            d_ij = abs(d_x) if abs(d_x) > 1e-4 else geometry.baseline_m

            best_tau, prom, c_phys, l_phys, is_valid = cls.gcc_phat_pair(
                sig_i, sig_j, fs, d_ij, min_signal_rms=min_active_rms * 0.40,
                gain_i=float(gains[i]) if i < len(gains) else 1.0,
                gain_j=float(gains[j]) if j < len(gains) else 1.0
            )
            pair_prominences.append(prom)

            if is_valid and len(c_phys) >= 5 and prom >= 0.70:
                valid_pairs_count += 1
                sin_p = np.clip((best_tau * SPEED_OF_SOUND) / d_x, -1.0, 1.0)
                pair_angles.append(float(np.rad2deg(np.arcsin(sin_p))))
                # 1D angular SRP: tau = +(d_x / c) * sin(theta) (Positive lag for sound on right)
                taus_1d = +(d_x / SPEED_OF_SOUND) * sin_angles
                pair_resp_1d = np.interp(taus_1d, l_phys, c_phys, left=0.0, right=0.0)
                pair_weight = math.sqrt(d_ij / geometry.baseline_m) * min(prom, 4.0)
                srp_profile += pair_weight * np.maximum(pair_resp_1d, 0.0)

                # 2D True Spatial SRP Backprojection across physical room grid
                tau_grid = +geometry.pair_delays[p_idx].ravel()
                pair_resp_2d = np.interp(tau_grid, l_phys, c_phys, left=0.0, right=0.0).reshape((GRID_Y, GRID_X))
                raw_2d_heatmap += pair_weight * np.maximum(pair_resp_2d, 0.0)

        # Consistency Gate: Require at least 1 valid pair to form a reliable bearing
        max_srp = float(np.max(srp_profile))
        if valid_pairs_count < 1 or max_srp < 1e-6:
            return (
                0.0,
                0.0,
                angles_deg,
                np.zeros_like(angles_deg),
                np.zeros((GRID_Y, GRID_X), dtype=np.float64),
                {
                    "pct_left": 33.3, "pct_center": 33.3, "pct_right": 33.3,
                    "dom_side": "NONE", "is_valid": False, "active_pairs": valid_pairs_count,
                    "avg_rms": avg_rms, "ch_rms": ch_rms, "calib_ch_rms": calib_ch_rms, "ch_status": ch_status,
                    "spatial_rho": max_spatial_rho, "status": "NO_VALID_GCC_PAIRS"
                }
            )

        srp_norm = srp_profile / max_srp
        k_peak = int(np.argmax(srp_norm))
        best_bearing_deg = float(angles_deg[k_peak])
        mean_srp = float(np.mean(srp_norm))
        std_srp = float(np.std(srp_norm)) + 1e-12
        composite_prom = max(0.0, (1.0 - mean_srp) / std_srp)

        # Contrast check: is the peak well-separated from the angular baseline?
        if composite_prom < 1.0:
            # Low contrast / diffuse acoustic field - return angular profile for display, flagged invalid
            return (
                best_bearing_deg,
                composite_prom,
                angles_deg,
                srp_norm,
                raw_2d_heatmap,
                {
                    "pct_left": 33.3, "pct_center": 33.3, "pct_right": 33.3,
                    "dom_side": "NONE", "is_valid": False, "active_pairs": valid_pairs_count,
                    "avg_rms": avg_rms, "ch_rms": ch_rms, "calib_ch_rms": calib_ch_rms, "ch_status": ch_status,
                    "spatial_rho": max_spatial_rho, "status": "LOW_ANGULAR_CONTRAST"
                }
            )

        # Multi-Pair Angular Consensus Gate:
        # When 3+ pairs are valid, verify at least 2 pairs agree within 25°
        agreeing_pairs = sum(1 for ang in pair_angles if abs(ang - best_bearing_deg) <= 25.0)
        if valid_pairs_count >= 3 and agreeing_pairs < 2:
            return (
                best_bearing_deg,
                composite_prom,
                angles_deg,
                srp_norm,
                raw_2d_heatmap,
                {
                    "pct_left": 33.3, "pct_center": 33.3, "pct_right": 33.3,
                    "dom_side": "NONE", "is_valid": False, "active_pairs": valid_pairs_count,
                    "avg_rms": avg_rms, "ch_rms": ch_rms, "calib_ch_rms": calib_ch_rms, "ch_status": ch_status,
                    "spatial_rho": max_spatial_rho, "status": "PAIR_ANGLE_DISAGREEMENT"
                }
            )

        # Sector Power & Side Intensity Breakdown with Noise-Floor Contrast
        l_mask = angles_deg < -15.0
        c_mask = (angles_deg >= -15.0) & (angles_deg <= 15.0)
        r_mask = angles_deg > 15.0

        baseline = float(np.percentile(srp_norm, 20)) if len(srp_norm) > 0 else 0.0
        contrast = np.maximum(0.0, srp_norm - baseline) ** 2.0

        p_l = float(np.sum(contrast[l_mask])) if np.any(l_mask) else 0.0
        p_c = float(np.sum(contrast[c_mask])) if np.any(c_mask) else 0.0
        p_r = float(np.sum(contrast[r_mask])) if np.any(r_mask) else 0.0

        # Calibrated Physical Flank Amplitude Weighting:
        # Fuses SRP angular contrast with calibrated microphone pair energy balance
        # (Left mics: M1, M2; Right mics: M3, M4)
        if len(calib_ch_rms) >= 4:
            e_left = 0.5 * (calib_ch_rms[0]**2 + calib_ch_rms[1]**2) + 1e-12
            e_right = 0.5 * (calib_ch_rms[2]**2 + calib_ch_rms[3]**2) + 1e-12
            e_tot_calib = e_left + e_right
            w_left = (e_left / e_tot_calib) * 2.0
            w_right = (e_right / e_tot_calib) * 2.0
            p_l *= (0.70 + 0.30 * w_left)
            p_r *= (0.70 + 0.30 * w_right)

        p_tot = p_l + p_c + p_r + 1e-12

        pct_left = (p_l / p_tot) * 100.0
        pct_center = (p_c / p_tot) * 100.0
        pct_right = (p_r / p_tot) * 100.0

        if best_bearing_deg > 15.0:
            dom_side = "RIGHT"
        elif best_bearing_deg < -15.0:
            dom_side = "LEFT"
        else:
            dom_side = "CENTER"

        side_metrics = {
            "pct_left": pct_left,
            "pct_center": pct_center,
            "pct_right": pct_right,
            "dom_side": dom_side,
            "is_valid": True,
            "active_pairs": valid_pairs_count,
            "avg_rms": avg_rms,
            "ch_rms": ch_rms,
            "calib_ch_rms": calib_ch_rms,
            "ch_status": ch_status,
            "spatial_rho": max_spatial_rho,
            "status": "LOCALIZED"
        }

        return best_bearing_deg, composite_prom, angles_deg, srp_norm, raw_2d_heatmap, side_metrics

    @classmethod
    def compute_srp_bearing(
        cls,
        signals: np.ndarray,
        fs: float,
        geometry: ArrayGeometry
    ) -> Tuple[float, float, np.ndarray, np.ndarray]:
        """Backward-compatible wrapper for 1D bearing estimation."""
        best_bearing, comp_prom, angles, srp_norm, _, _ = cls.compute_srp_frame(signals, fs, geometry)
        return best_bearing, comp_prom, angles, srp_norm

    @classmethod
    def compute_true_2d_acoustic_heatmap(
        cls, raw_2d_heatmap: np.ndarray, target_range_m: float, avg_rms: float,
        is_locked: bool, geometry: ArrayGeometry, noise_floor: float = 0.0030
    ) -> np.ndarray:
        """Fixed monotonic thermal intensity from SRP shape and RMS above ambient.

        Relative digital level, not calibrated dB SPL. A 1D ULA measures bearing,
        not source range; radial weighting is only for display.
        """
        raw = np.asarray(raw_2d_heatmap, dtype=np.float64)
        raw = np.nan_to_num(raw, nan=0.0, posinf=0.0, neginf=0.0)
        spatial = np.maximum(raw, 0.0)
        peak = float(np.max(spatial)) if spatial.size else 0.0
        if peak <= 1e-12:
            return np.zeros_like(raw, dtype=np.float64)
        # Normalize spatial shape only; never normalize final intensity per frame.
        spatial /= peak
        spatial = gaussian_filter(spatial, sigma=1.15, mode="nearest")
        spatial_peak = float(np.max(spatial))
        if spatial_peak <= 1e-12:
            return np.zeros_like(raw, dtype=np.float64)
        spatial /= spatial_peak
        r_grid = np.sqrt(geometry.xx ** 2 + geometry.yy ** 2)
        dist_weight = 1.0 / np.sqrt(np.maximum(r_grid, 0.40))
        dist_weight /= max(float(np.max(dist_weight)), 1e-12)
        spatial *= dist_weight
        spatial /= max(float(np.max(spatial)), 1e-12)
        # Fixed monotonic 1.5–16 dB-above-ambient digital scale.
        floor = max(float(noise_floor), 0.0008)
        level_db = 20.0 * math.log10(max(float(avg_rms), 1e-9) / floor)
        level = float(np.clip((level_db - 1.5) / 14.5, 0.0, 1.0))
        return np.clip(np.power(np.clip(spatial, 0.0, 1.0), 1.35) * level, 0.0, 1.0)

    @classmethod
    def synthesize_directional_map(
        cls,
        bearing_deg: float,
        target_range_m: float,
        confidence_pct: float,
        geometry: ArrayGeometry
    ) -> np.ndarray:
        """Synthetic fallback spotlight."""
        xx, yy = geometry.xx, geometry.yy
        angles_grid = np.rad2deg(np.arctan2(xx, yy))
        ranges_grid = np.sqrt(xx ** 2 + yy ** 2)

        beam_width = 8.0 if geometry.num_mics >= 4 else 10.0
        ang_diff = angles_grid - bearing_deg
        beam = np.exp(-0.5 * (ang_diff / beam_width) ** 2)

        r_weight = 1.0 / np.sqrt(np.maximum(ranges_grid, 0.4))
        r_weight /= np.max(r_weight)

        range_diff = ranges_grid - target_range_m
        spot = np.exp(-0.5 * (range_diff / 0.70) ** 2)

        intensity = 0.65 * beam * r_weight + 0.35 * beam * spot
        effective_conf = confidence_pct / 100.0
        intensity *= effective_conf
        return np.clip(intensity, 0.0, 1.0)


# =============================================================================
# ACOUSTIC EVENT CLASSIFIER & ISO 10816 VIBRATION SEVERITY
# =============================================================================
class AcousticClassifier:
    """Diagnoses acoustic & vibration signatures for rotating machinery."""

    @staticmethod
    def classify(audio: np.ndarray, fs: float, vib_mag_g: float) -> Dict[str, object]:
        x = audio.mean(axis=1).astype(np.float64)
        x -= np.mean(x)
        rms = float(np.sqrt(np.mean(x ** 2)))
        peak = float(np.max(np.abs(x))) if len(x) else 0.0

        # Dynamic Vibration Severity Index (Empirical zones inspired by ISO 10816 Class 1)
        # Note: Strict ISO 10816 requires velocity RMS (mm/s). Here, dynamic acceleration magnitude
        # (dynamic_g = |vib_mag - 1.0g| in g) provides an indicative edge severity proxy.
        dynamic_g = max(0.0, vib_mag_g - 1.0) # Subtract 1g static gravity
        if dynamic_g > 0.45:
            severity = "ALERT: EXCESSIVE VIBRATION (ISO Zone D Proxy)"
        elif dynamic_g > 0.20:
            severity = "WARNING: ELEVATED VIBRATION (ISO Zone C Proxy)"
        else:
            severity = "NOMINAL: HEALTHY VIBRATION (ISO Zone A/B Proxy)"

        if rms < 1e-4:
            return {
                "label": "AMBIENT / QUIET",
                "confidence": 0,
                "severity": severity,
                "detail": "Acoustic signal within background noise floor."
            }

        crest = peak / max(rms, 1e-12)
        kurt = float(kurtosis(x, fisher=False, bias=False))

        f, pxx = welch(x, fs=fs, nperseg=min(1024, len(x)), noverlap=None)
        total_p = np.sum(pxx) + 1e-20

        voice_band = float(np.sum(pxx[(f >= 250) & (f <= 3500)]) / total_p)
        high_band = float(np.sum(pxx[(f >= 4000) & (f <= 10000)]) / total_p)
        centroid = float(np.sum(f * pxx) / total_p)
        geo_mean = np.exp(np.mean(np.log(np.maximum(pxx, 1e-20))))
        flatness = float(geo_mean / np.maximum(np.mean(pxx), 1e-20))

        valid_idx = (f >= 40) & (f <= min(fs / 2 - 1, 10000))
        if np.any(valid_idx):
            fv, pv = f[valid_idx], pxx[valid_idx]
            dom_idx = int(np.argmax(pv))
            dom_freq = float(fv[dom_idx])
            dom_ratio = float(pv[dom_idx] / np.sum(pv))
        else:
            dom_freq, dom_ratio = 0.0, 0.0

        if crest > 5.5 and kurt > 5.0:
            return {
                "label": "IMPACT / TRANSIENT BEARING TAP",
                "confidence": int(min(98, 55 + 5 * crest)),
                "severity": severity,
                "detail": f"Impulsive contact (Crest: {crest:.1f}, Kurtosis: {kurt:.1f})."
            }

        if dom_ratio > 0.15 and 40 <= dom_freq <= 3500:
            return {
                "label": "ROTATING MACHINERY / TONAL HARMONICS",
                "confidence": int(min(96, 50 + 200 * dom_ratio)),
                "severity": severity,
                "detail": f"Shaft/Blade tonal harmonic peak at {dom_freq:.0f} Hz ({dom_ratio*100:.1f}% peak ratio)."
            }

        if voice_band > 0.40 and 250 <= centroid <= 3200 and flatness < 0.60:
            return {
                "label": "SPEECH / VOICE / ACOUSTIC MEDIA",
                "confidence": int(min(95, 50 + 40 * voice_band)),
                "severity": severity,
                "detail": f"Voice-band acoustic activity (Centroid: {centroid:.0f} Hz)."
            }

        if flatness > 0.48 and high_band > 0.20 and centroid > 2200:
            return {
                "label": "BROADBAND HISS / BEARING FRICTION",
                "confidence": int(min(92, 45 + 40 * high_band)),
                "severity": severity,
                "detail": f"High-frequency acoustic friction (Centroid: {centroid:.0f} Hz)."
            }

        return {
            "label": "UNCLASSIFIED SOUND SOURCE",
            "confidence": 35,
            "severity": severity,
            "detail": f"Mixed energy profile. RMS: {rms:.4f}, Centroid: {centroid:.0f} Hz."
        }


# =============================================================================
# MULTIMODAL DC MOTOR DIAGNOSTICS & SENSOR FUSION ENGINE
# =============================================================================
class MultimodalMotorEngine:
    """
    Advanced Multimodal Sensor Fusion Engine for DC Motors:
    Fuses:
      1. FC-03 Optical Tachometer (Exact Shaft RPM, Jitter & Pulses)
      2. ADXL345 3-Axis Accelerometer (Chassis Dynamic Vibration, ISO 10816 Severity)
      3. 4-Mic INMP441 Acoustic Array (Harmonic Orders 1x/2x/3x, Kurtosis, Crest Factor, 2D Camera)
    Capabilities:
      - Learn & Lock 'Golden Baseline' of healthy motor with Key 'B'
      - Real-time Delta Deviation Detection (catches tiny differences)
      - Composite Motor Health Score (0 - 100%)
      - Specific Fault Classification (Unbalance, Misalignment, Brush Arcing, Bearing Impact)
    """

    def __init__(self, pulses_per_rev: int = 1):
        self.pulses_per_rev = pulses_per_rev
        self.baseline_locked = False
        self.b_rpm = 0.0
        self.b_vib_g = 0.0
        self.b_rms = 0.0
        self.b_kurt = 3.0
        self.b_spec = None
        self.b_time = 0.0
        self.rpm_history = collections.deque(maxlen=20)

        # Per-axis gravity tracking & vibration time series buffer
        self.grav_x = 0.0
        self.grav_y = 0.0
        self.grav_z = -0.82
        self.vib_history = collections.deque(maxlen=256)
        self.vib_signed_history = collections.deque(maxlen=256)
        self.vib_signed_y_history = collections.deque(maxlen=256)
        self.vib_signed_z_history = collections.deque(maxlen=256)

    def learn_baseline(self, rpm: float, vib_g: float, audio: np.ndarray, fs: float):
        """Captures golden baseline signature of a known-healthy motor."""
        x = audio.mean(axis=1).astype(np.float64) if audio.ndim > 1 else audio.astype(np.float64)
        x -= np.mean(x)
        rms = float(np.sqrt(np.mean(x**2)))
        kurt = float(np.mean(x**4) / (np.mean(x**2)**2 + 1e-12))
        spec = np.abs(np.fft.rfft(x))

        self.b_rpm = max(10.0, rpm)
        self.b_vib_g = max(0.01, vib_g)
        self.b_rms = max(1e-4, rms)
        self.b_kurt = kurt
        self.b_spec = spec / (np.max(spec) + 1e-12)
        self.baseline_locked = True
        self.b_time = time.time()
        print(f"[+] Motor Baseline Learned & Locked: {self.b_rpm:.1f} RPM, {self.b_vib_g:.2f}g vib, RMS={self.b_rms:.4f}")
        return {
            "status": "LOCKED",
            "rpm": self.b_rpm,
            "vib_g": self.b_vib_g,
            "kurt": self.b_kurt,
            "rms": self.b_rms
        }

    def reset_baseline(self):
        self.baseline_locked = False
        self.b_spec = None
        print("[+] Motor Baseline Reset.")

    def analyze(
        self,
        audio: np.ndarray,
        fs: float,
        ax_g: float,
        ay_g: float,
        az_g: float,
        rpm: float,
        vib_history: Optional[Tuple[np.ndarray, np.ndarray, np.ndarray, np.ndarray]] = None
    ) -> Dict[str, object]:
        """Cross-fuses all 3 sensors to diagnose motor condition & compute Health Index."""
        x = audio.mean(axis=1).astype(np.float64) if audio.ndim > 1 else audio.astype(np.float64)
        x -= np.mean(x)
        rms = float(np.sqrt(np.mean(x**2)))
        peak = float(np.max(np.abs(x))) if len(x) else 0.0
        crest = peak / max(rms, 1e-12)
        kurt = float(np.mean(x**4) / (np.mean(x**2)**2 + 1e-12)) if len(x) else 3.0

        # Track RPM jitter (bounded by deque maxlen=20)
        self.rpm_history.append(rpm)
        rpm_jitter = float(np.std(self.rpm_history)) if len(self.rpm_history) > 3 else 0.0

        # 1. Decoupled Dynamic Vibration Magnitude (Per-Axis Gravity DC Removal)
        if vib_history is not None and len(vib_history[1]) >= 16:
            t_vib, ax_arr, ay_arr, az_arr = vib_history
            # Slow EMA tracks static orientation/gravity vector from batch average
            self.grav_x = 0.90 * self.grav_x + 0.10 * float(np.mean(ax_arr))
            self.grav_y = 0.90 * self.grav_y + 0.10 * float(np.mean(ay_arr))
            self.grav_z = 0.90 * self.grav_z + 0.10 * float(np.mean(az_arr))

            # Signed dynamic acceleration components (free of static 1g gravity offset)
            dyn_ax_arr = ax_arr - self.grav_x
            dyn_ay_arr = ay_arr - self.grav_y
            dyn_az_arr = az_arr - self.grav_z

            # Robust RMS dynamic vibration magnitude across window (eliminates point-sample flicker)
            dyn_mag_sq = dyn_ax_arr**2 + dyn_ay_arr**2 + dyn_az_arr**2
            dyn_g = float(np.sqrt(np.mean(dyn_mag_sq)))

            # 3-Axis Signed Vibration Components for Orientation-Invariant Order Tracking
            dyn_axes = [dyn_ax_arr, dyn_ay_arr, dyn_az_arr]

            # Effective vibration sampling rate from hardware timestamps
            dt_span = float(t_vib[-1] - t_vib[0])
            if dt_span > 1e-4 and len(t_vib) > 1:
                fs_vib = float(len(t_vib) - 1) / dt_span
            else:
                fs_vib = 86.13
        else:
            self.grav_x = 0.95 * self.grav_x + 0.05 * ax_g
            self.grav_y = 0.95 * self.grav_y + 0.05 * ay_g
            self.grav_z = 0.95 * self.grav_z + 0.05 * az_g

            dyn_ax = ax_g - self.grav_x
            dyn_ay = ay_g - self.grav_y
            dyn_az = az_g - self.grav_z

            dyn_pt = math.sqrt(dyn_ax**2 + dyn_ay**2 + dyn_az**2)
            self.vib_history.append(dyn_pt)
            self.vib_signed_history.append(dyn_ax)
            self.vib_signed_y_history.append(dyn_ay)
            self.vib_signed_z_history.append(dyn_az)

            dyn_g = float(np.sqrt(np.mean(np.array(self.vib_history)**2)))
            dyn_axes = [
                np.array(self.vib_signed_history, dtype=np.float64),
                np.array(self.vib_signed_y_history, dtype=np.float64),
                np.array(self.vib_signed_z_history, dtype=np.float64)
            ]
            fs_vib = 86.13

        # Vibration severity grading (Project Dynamic Vibration Severity Index inspired by ISO vibration zones)
        if dyn_g < 0.15:
            iso_severity = "ZONE A: GOOD / NOMINAL (Severity Index)"
            iso_color = "#00ffcc"
            vib_penalty = dyn_g / 0.15 * 5.0
        elif dyn_g < 0.35:
            iso_severity = "ZONE B: PERMISSIBLE (Severity Index)"
            iso_color = "#33ccff"
            vib_penalty = 5.0 + (dyn_g - 0.15) / 0.20 * 15.0
        elif dyn_g < 0.70:
            iso_severity = "ZONE C: WARNING (Severity Index)"
            iso_color = "#ffaa00"
            vib_penalty = 20.0 + (dyn_g - 0.35) / 0.35 * 30.0
        else:
            iso_severity = "ZONE D: UNACCEPTABLE (Severity Index)"
            iso_color = "#ff0055"
            vib_penalty = 50.0 + min(35.0, (dyn_g - 0.70) * 40.0)

        is_motor_running = bool(rpm >= 30.0)

        # 2. Rotational Order Analysis from Multi-Axis Power Spectrum (Orientation Invariant, No Rectification Doubling)
        f0 = (rpm / 60.0) if is_motor_running else 0.0
        n_samples_vib = len(dyn_axes[0])
        if is_motor_running and n_samples_vib >= 32 and rpm > 60.0:
            n_fft = max(256, n_samples_vib * 4)  # Zero-padding for ~0.08 Hz bin spacing
            vib_freqs = np.fft.rfftfreq(n_fft, d=1.0 / fs_vib)
            # Sum power spectra of each signed axis: P(f) = |X(f)|^2 + |Y(f)|^2 + |Z(f)|^2
            vib_power_spec = np.zeros_like(vib_freqs, dtype=np.float64)
            for axis_sig in dyn_axes:
                axis_ac = np.array(axis_sig, dtype=np.float64)
                axis_ac -= np.mean(axis_ac)
                vib_power_spec += np.abs(np.fft.rfft(axis_ac, n=n_fft)) ** 2

            def get_order_energy(target_f, bandwidth=1.5):
                mask = (vib_freqs >= max(0.5, target_f - bandwidth)) & (vib_freqs <= target_f + bandwidth)
                return float(np.sum(vib_power_spec[mask])) if np.any(mask) else 0.0

            tot_vib_energy = float(np.sum(vib_power_spec)) + 1e-15
            e_1x = get_order_energy(f0) / tot_vib_energy
            e_2x = get_order_energy(2.0 * f0) / tot_vib_energy
            e_3x = get_order_energy(3.0 * f0) / tot_vib_energy
        else:
            e_1x = 0.0
            e_2x = 0.0
            e_3x = 0.0

        # True ISO 10816/20816 Vibration Velocity RMS (mm/s) via Parseval Omega-Arithmetic Integration
        # V(f) = (A_w(f) * 9806.65) / (2 * pi * f) for f in [10 Hz, 200 Hz]
        v_rms_mms = 0.0
        if n_samples_vib >= 16:
            n_vfft = max(128, n_samples_vib)
            v_freqs = np.fft.rfftfreq(n_vfft, d=1.0 / fs_vib)
            iso_band = (v_freqs >= 10.0) & (v_freqs <= min(200.0, fs_vib / 2.0))
            if np.any(iso_band):
                v_axis_rms_sq = 0.0
                scale = np.full_like(v_freqs, 2.0)
                scale[0] = 1.0
                if n_vfft % 2 == 0:
                    scale[-1] = 1.0

                safe_freqs = v_freqs.copy()
                safe_freqs[0] = 1.0  # Guard against DC division

                for axis_sig in dyn_axes:
                    ax_data = np.array(axis_sig, dtype=np.float64)
                    if len(ax_data) < 16:
                        continue
                    ax_data -= np.mean(ax_data)
                    w_v = np.hanning(len(ax_data))
                    sum_w_sq = float(np.sum(w_v**2)) + 1e-12

                    X_w = np.fft.rfft(ax_data * w_v, n=n_vfft)
                    # Velocity spectral amplitude (mm/s)
                    V_w = (np.abs(X_w) * 9806.65) / (2.0 * np.pi * safe_freqs)
                    # Parseval discrete energy integration
                    axis_v_rms_sq = float(np.sum(scale[iso_band] * (V_w[iso_band]**2))) / (n_vfft * sum_w_sq)
                    v_axis_rms_sq += axis_v_rms_sq

                v_rms_mms = float(np.sqrt(v_axis_rms_sq))

        # Acoustic spectrum for high-frequency acoustic baseline comparison
        spec = np.abs(np.fft.rfft(x))

        # 3. Fault Classification Diagnostics (Multimodal Edge-AI Decision Rules)
        is_acoustic_elevated = bool(rms > 0.025 or kurt > 4.2 or crest > 4.2)
        is_vib_elevated = bool(dyn_g > 0.25)

        if not is_motor_running:
            fault_label = "MOTOR STOPPED / STANDBY (Awaiting Rotation)"
            iso_severity = "STANDBY: MOTOR OFF"
            iso_color = "#64748b"
        elif is_vib_elevated and dyn_g > 0.40 and e_1x > 0.12:
            fault_label = "MASS UNBALANCE (Strong 1x RPM Vibration)"
        elif is_vib_elevated and dyn_g > 0.30 and e_2x > 0.10:
            fault_label = "SHAFT MISALIGNMENT / BENT (Strong 2x RPM)"
        elif is_vib_elevated and crest > 4.5 and kurt > 4.5:
            fault_label = "BEARING IMPACT / BRUSH ARCING (High Kurtosis)"
        elif is_vib_elevated and dyn_g > 0.35:
            fault_label = "ELEVATED MECHANICAL VIBRATION (ISO Zone C Alert)"
        elif is_acoustic_elevated and not is_vib_elevated:
            # Core Minor Project Principle (PDF Page 13): Acoustic Disturbance != Mechanical Fault
            fault_label = "ACOUSTIC DISTURBANCE DETECTED (Vibration Nominal -> Non-Mechanical)"
        elif rms > 0.035 and kurt < 2.5:
            fault_label = "COMMUTATOR NOISE / MECHANICAL DRAG"
        else:
            fault_label = "NOMINAL / SMOOTH OPERATION"

        # 4. Golden Baseline Comparison (Detecting Tiny Differences!)
        delta_info = {
            "d_rpm": 0.0,
            "d_vib_g": 0.0,
            "d_kurt": 0.0,
            "d_rms_pct": 0.0,
            "spec_dist_pct": 0.0
        }
        delta_penalty = 0.0
        if self.baseline_locked and is_motor_running:
            d_rpm = rpm - self.b_rpm
            d_vib = dyn_g - self.b_vib_g
            d_kurt = kurt - self.b_kurt
            d_rms_pct = ((rms - self.b_rms) / self.b_rms) * 100.0

            curr_norm_spec = spec / (np.max(spec) + 1e-12)
            n_min = min(len(curr_norm_spec), len(self.b_spec))
            spec_dist = float(np.mean(np.abs(curr_norm_spec[:n_min] - self.b_spec[:n_min]))) * 100.0

            delta_info = {
                "d_rpm": d_rpm,
                "d_vib_g": d_vib,
                "d_kurt": d_kurt,
                "d_rms_pct": d_rms_pct,
                "spec_dist_pct": spec_dist
            }
            # Sensitive penalty for any deviation from learned baseline
            delta_penalty = (
                abs(d_vib) * 35.0 +
                max(0.0, d_kurt) * 3.5 +
                min(20.0, abs(d_rms_pct) * 0.15) +
                min(15.0, spec_dist * 0.35)
            )

        # 5. Composite Motor Health Score (0 - 100%)
        if not is_motor_running:
            health_score = 0.0
        else:
            total_penalty = vib_penalty + max(0.0, (kurt - 3.0) * 3.0) + delta_penalty
            if is_acoustic_elevated and not is_vib_elevated:
                # External environmental acoustic noise must not degrade mechanical motor health rating
                total_penalty = min(total_penalty, 5.0)
            health_score = max(5.0, min(100.0, 100.0 - total_penalty))

        return {
            "is_running": is_motor_running,
            "health_score": health_score,
            "rpm": rpm,
            "rpm_jitter": rpm_jitter,
            "f0_hz": f0,
            "dyn_vib_g": dyn_g,
            "v_rms_mms": v_rms_mms,
            "iso_severity": iso_severity,
            "iso_color": iso_color,
            "crest_factor": crest,
            "kurtosis": kurt,
            "primary_fault": fault_label,
            "e_1x_pct": e_1x * 100.0,
            "e_2x_pct": e_2x * 100.0,
            "e_3x_pct": e_3x * 100.0,
            "baseline_locked": self.baseline_locked,
            "delta": delta_info
        }


# =============================================================================
# MULTI-SOURCE AUDIO & SENSOR INGESTION ENGINES
# =============================================================================
class AudioSourceBase:
    def start(self): raise NotImplementedError
    def stop(self): raise NotImplementedError
    def get_frame(self) -> np.ndarray: raise NotImplementedError
    def get_fs(self) -> float: raise NotImplementedError
    def get_channels(self) -> int: return 4
    def get_multimodal_telemetry(self) -> Dict[str, object]: return {}
    def get_vibration_history(self, max_samples: int = 512) -> Tuple[np.ndarray, np.ndarray, np.ndarray, np.ndarray]:
        return np.array([]), np.array([]), np.array([]), np.array([])


def compute_packet_checksum(data: bytes) -> int:
    """
    Computes 16-bit XOR checksum initialized to 0x55AA across contiguous byte buffer.
    Matches ESP32 firmware implementation for serial binary packets.
    """
    chk = 0x55AA
    for i, b in enumerate(data):
        chk ^= ((b << (i % 8)) & 0xFFFF)
    return chk & 0xFFFF


class ESP32MultimodalSource(AudioSourceBase):
    """
    Production 4-Channel Real-Time PCM Ingestion from ESP32 on COM8.
    Streams 10,000 Hz 16-bit 4-channel audio + ADXL345 3-axis vibration (continuous 400 Hz FIFO stream)
    + FC-03 tachometer at 921,600 baud using zero-copy binary DMA packets (packet type 0x05).
    """

    def __init__(self, port: str = "auto", baudrates: Tuple[int, ...] = (921600, 1152000, 115200)):
        self.port = port
        self.baudrates = baudrates
        self.fs = 10000.0
        self.channels = 4
        self.frame_len = 512

        self.buffer = np.zeros((self.frame_len, self.channels), dtype=np.float32)
        self.packets_valid = 0
        self.checksum_errors = 0
        self.dropped_packets = 0
        self.last_seq: Optional[int] = None
        self.last_packet_time = 0.0

        # Thread-safe ring buffer for decoupling accelerometer acquisition from GUI thread
        self.vib_ring_lock = threading.Lock()
        self.vib_ring_time = collections.deque(maxlen=2048)
        self.vib_ring_ax = collections.deque(maxlen=2048)
        self.vib_ring_ay = collections.deque(maxlen=2048)
        self.vib_ring_az = collections.deque(maxlen=2048)

        self._rx_buf = bytearray()

        self.telemetry = {
            "ax_g": 0.0, "ay_g": -0.02, "az_g": -0.82,
            "rpm_pulses": 0, "estimated_rpm": 0.0,
            "firmware_mode": "CONNECTING...",
            "rms_counts": [0.0, 0.0, 0.0, 0.0],
            "peak_counts": [0, 0, 0, 0],
            "is_hardware_alive": False,
            "packets_valid": 0,
            "checksum_errors": 0,
            "dropped_packets": 0,
            "channels_active": 0,
            "last_packet_time": 0.0,
            "num_vib_last": 0,
            "port": port if port != "auto" else "COM8",
        }
        self.lock = threading.Lock()
        self.running = False
        self.thread: Optional[threading.Thread] = None
        self.ser: Optional[serial.Serial] = None
        self.last_pulse_count = 0
        self.last_pulse_time = time.time()

    def get_vibration_history(self, max_samples: int = 512) -> Tuple[np.ndarray, np.ndarray, np.ndarray, np.ndarray]:
        with self.vib_ring_lock:
            if len(self.vib_ring_ax) == 0:
                return np.array([]), np.array([]), np.array([]), np.array([])
            ax = np.array(self.vib_ring_ax, dtype=np.float32)
            ay = np.array(self.vib_ring_ay, dtype=np.float32)
            az = np.array(self.vib_ring_az, dtype=np.float32)
            t = np.array(self.vib_ring_time, dtype=np.float64)
        if len(ax) > max_samples:
            ax = ax[-max_samples:]
            ay = ay[-max_samples:]
            az = az[-max_samples:]
            t = t[-max_samples:]
        return t, ax, ay, az

    def _find_port(self) -> str:
        if not SERIAL_AVAILABLE:
            return self.port if self.port and self.port != "auto" else "COM8"
        # If user explicitly specified a port that isn't "auto", try that directly
        if self.port and self.port.lower() != "auto":
            return self.port

        # Try standalone hardware port detector
        try:
            tools_dir = os.path.join(os.path.dirname(os.path.dirname(os.path.dirname(os.path.abspath(__file__)))), "tools")
            if tools_dir not in sys.path:
                sys.path.insert(0, tools_dir)
            import find_port
            detected = find_port.detect_port()
            if detected:
                return detected
        except Exception:
            pass

        # Robust in-situ detection with Bluetooth / ACPI rejection
        try:
            ports = list(serial.tools.list_ports.comports())
            for p in ports:
                h = ((p.hwid or "") + " " + (p.description or "")).lower()
                if any(b in h for b in ["bthenum", "bluetooth", "acpi", "pnp0501"]):
                    continue
                if any(k in h for k in ["10c4:ea60", "cp210", "1a86:7523", "ch340", "0403:6001", "ftdi", "303a:", "esp32"]):
                    return p.device
            for p in ports:
                h = ((p.hwid or "") + " " + (p.description or "")).lower()
                if any(b in h for b in ["bthenum", "bluetooth", "acpi", "pnp0501"]):
                    continue
                if "usb" in h:
                    return p.device
            for p in ports:
                if p.device.upper() == "COM8":
                    return p.device
        except Exception:
            pass
        return "COM8"

    def start(self):
        if not SERIAL_AVAILABLE:
            return
        self.running = True
        self.thread = threading.Thread(target=self._worker, daemon=True)
        self.thread.start()

    def stop(self):
        self.running = False
        if self.ser and self.ser.is_open:
            try: self.ser.close()
            except Exception: pass

    @staticmethod
    def build_packet_v2(
        seq: int,
        fs: int,
        block_frames: int,
        accel_samples: List[Tuple[int, int, int]],
        audio_data: np.ndarray,
        tach_pulses: int = 0
    ) -> bytes:
        """
        Constructs a binary Packet Type 0x05 (PKT_TYPE_4CH_MULTIVIB) frame per PROJECT.md interface contract.
        Header: 16 bytes (sync1, sync2, pkt_type=0x05, channels=4, seq, fs, block_frames, num_vib, reserved, pulses)
        Vibration payload: num_vib * 6 bytes (int16 x_mg, y_mg, z_mg)
        Audio payload: block_frames * 4 * 2 bytes (int16 PCM)
        Checksum: 16-bit XOR initialized to 0x55AA across header, vibration, and audio payloads.
        """
        num_vib = len(accel_samples)
        header = struct.pack(
            "<BBBBHHHBBI",
            0xAA, 0x55, 0x05, 4,
            seq & 0xFFFF,
            int(fs) & 0xFFFF,
            int(block_frames) & 0xFFFF,
            num_vib & 0xFF,
            0x00,
            tach_pulses & 0xFFFFFFFF
        )
        vib_bytes = bytearray()
        for x, y, z in accel_samples:
            vib_bytes.extend(struct.pack("<hhh", int(x), int(y), int(z)))

        if audio_data.dtype in (np.float32, np.float64):
            audio_int16 = (np.clip(audio_data, -1.0, 1.0) * 32767.0).astype(np.int16)
        else:
            audio_int16 = audio_data.astype(np.int16)
        audio_bytes = audio_int16.tobytes()

        data_to_checksum = header + bytes(vib_bytes) + audio_bytes
        chk = compute_packet_checksum(data_to_checksum)
        chk_bytes = struct.pack("<H", chk)

        return data_to_checksum + chk_bytes

    @staticmethod
    def build_packet_v1(
        seq: int,
        fs: int,
        block_frames: int,
        accel_sample: Tuple[int, int, int],
        audio_data: np.ndarray,
        tach_pulses: int = 0
    ) -> bytes:
        """
        Constructs a legacy binary Packet Type 0x04 frame for backward compatibility testing.
        """
        ax_mg, ay_mg, az_mg = accel_sample
        header = struct.pack(
            "<BBBBHHHhhhI",
            0xAA, 0x55, 0x04, 4,
            seq & 0xFFFF,
            int(fs) & 0xFFFF,
            int(block_frames) & 0xFFFF,
            int(ax_mg), int(ay_mg), int(az_mg),
            tach_pulses & 0xFFFFFFFF
        )
        if audio_data.dtype in (np.float32, np.float64):
            audio_int16 = (np.clip(audio_data, -1.0, 1.0) * 32767.0).astype(np.int16)
        else:
            audio_int16 = audio_data.astype(np.int16)
        audio_bytes = audio_int16.tobytes()

        chk = 0x55AA
        for i, b in enumerate(header):
            chk ^= ((b << (i % 8)) & 0xFFFF)
        for i, b in enumerate(audio_bytes):
            chk ^= ((b << (i % 8)) & 0xFFFF)
        chk_bytes = struct.pack("<H", chk)

        return header + audio_bytes + chk_bytes

    def _parse_incoming_bytes(self, chunk: bytes, port_str: str = "COM8", baud_str: Union[int, str] = 1152000) -> int:
        """
        Parses incoming serial byte stream into ring buffers and telemetry.
        Handles both Type 0x05 (multi-sample continuous 400Hz vibration) and Type 0x04 (legacy single-sample).
        Validates 16-bit XOR checksum, tracks dropped packets via sequence counter, and rejects corruption.
        Returns the number of valid packets extracted in this call.
        """
        HEADER_FORMAT_V2 = "<BBBBHHHBBI"  # 16 bytes: sync1, sync2, pkt_type, channels, seq, fs, block_frames, num_vib, reserved, pulses
        HEADER_SIZE_V2 = struct.calcsize(HEADER_FORMAT_V2)

        HEADER_FORMAT_V1 = "<BBBBHHHhhhI"  # 20 bytes: sync1, sync2, pkt_type, channels, seq, fs, block_frames, ax, ay, az, pulses
        HEADER_SIZE_V1 = struct.calcsize(HEADER_FORMAT_V1)

        self._rx_buf.extend(chunk)
        buf = self._rx_buf
        parsed_count = 0

        while len(buf) >= 3:
            sync_idx = -1
            for i in range(len(buf) - 1):
                if buf[i] == 0xAA and buf[i+1] == 0x55:
                    sync_idx = i
                    break

            if sync_idx == -1:
                if len(buf) > 0 and buf[-1] == 0xAA:
                    del buf[:-1]
                else:
                    buf.clear()
                break

            if sync_idx > 0:
                del buf[:sync_idx]

            if len(buf) < 3:
                break

            pkt_type = buf[2]

            if pkt_type == 0x05:
                if len(buf) < HEADER_SIZE_V2:
                    break

                sync1, sync2, ptype, channels, seq, fs_val, block_frames, num_vib, reserved, pulses = struct.unpack_from(
                    HEADER_FORMAT_V2, buf, 0
                )

                # Defensive sanity check: enforce interface contract bounds before calculating total_pkt_len
                if channels != 4 or block_frames != 128 or num_vib > 32 or fs_val < 1000 or fs_val > 96000:
                    # Corrupted or false sync: advance past sync and continue scanning
                    del buf[:2]
                    continue

                vib_len = num_vib * 6
                audio_len = block_frames * channels * 2
                total_pkt_len = HEADER_SIZE_V2 + vib_len + audio_len + 2
                if len(buf) < total_pkt_len:
                    break

                # 16-bit XOR Checksum Validation across header, vibration payload, and audio payload
                expected_chk = struct.unpack_from("<H", buf, total_pkt_len - 2)[0]
                data_bytes = bytes(buf[0 : total_pkt_len - 2])
                chk = compute_packet_checksum(data_bytes)

                if (chk & 0xFFFF) != (expected_chk & 0xFFFF):
                    self.checksum_errors += 1
                    del buf[:2]
                    continue

                # Valid Type 0x05 Packet
                parsed_count += 1
                self.packets_valid += 1
                if self.last_seq is not None:
                    expected_seq = (self.last_seq + 1) & 0xFFFF
                    if seq != expected_seq:
                        drop = (seq - expected_seq) & 0xFFFF
                        if drop < 500:
                            self.dropped_packets += drop
                self.last_seq = seq
                self.last_packet_time = time.time()

                vib_bytes = bytes(buf[HEADER_SIZE_V2 : HEADER_SIZE_V2 + vib_len])
                audio_bytes = bytes(buf[HEADER_SIZE_V2 + vib_len : HEADER_SIZE_V2 + vib_len + audio_len])

                if num_vib > 0:
                    raw_vib = np.frombuffer(vib_bytes, dtype=np.int16).reshape((num_vib, 3)).astype(np.float32) / 1000.0
                    t_pkt = self.last_packet_time
                    dt_vib = 1.0 / 400.0
                    t_start = t_pkt - (num_vib - 1) * dt_vib
                    with self.vib_ring_lock:
                        if len(self.vib_ring_time) > 0:
                            last_t = self.vib_ring_time[-1]
                            # If batch is advancing (t_pkt < last_t) or last sample was recent (< 0.5s in past), enforce monotonicity
                            if (t_pkt - last_t) < 0.5:
                                t_start = max(t_start, last_t + dt_vib)
                        for k in range(num_vib):
                            self.vib_ring_time.append(t_start + k * dt_vib)
                            self.vib_ring_ax.append(float(raw_vib[k, 0]))
                            self.vib_ring_ay.append(float(raw_vib[k, 1]))
                            self.vib_ring_az.append(float(raw_vib[k, 2]))
                    latest_ax = float(raw_vib[-1, 0])
                    latest_ay = float(raw_vib[-1, 1])
                    latest_az = float(raw_vib[-1, 2])
                else:
                    latest_ax, latest_ay, latest_az = 0.0, 0.0, -0.82

                samples = np.frombuffer(audio_bytes, dtype=np.int16).reshape((block_frames, channels)).astype(np.float32) / 32768.0
                rms_ch = [float(np.sqrt(np.mean(samples[:, ch].astype(np.float64)**2))) for ch in range(channels)]
                active_channels = sum(1 for r in rms_ch if r > 0.0003)

                with self.lock:
                    if samples.shape == (block_frames, self.channels):
                        self.buffer = np.roll(self.buffer, -block_frames, axis=0)
                        self.buffer[-block_frames:, :] = samples
                    self.fs = float(fs_val)

                    now = time.time()
                    dt = now - self.last_pulse_time
                    if dt >= 0.5:
                        dp = pulses - self.last_pulse_count
                        if dp >= 0 and dt > 0:
                            self.telemetry["estimated_rpm"] = (dp / dt) * 60.0
                        self.last_pulse_count = pulses
                        self.last_pulse_time = now

                    adxl_hw_ok = bool(reserved & 0x01)
                    adxl_hw_str = "ADXL345: ONLINE (400Hz FIFO)" if adxl_hw_ok else "ADXL345: OFFLINE / ABSENT"

                    self.telemetry.update({
                        "port": str(port_str),
                        "baud": str(baud_str),
                        "ax_g": latest_ax,
                        "ay_g": latest_ay,
                        "az_g": latest_az,
                        "rpm_pulses": pulses,
                        "adxl_hw_ok": adxl_hw_ok,
                        "adxl_hw_str": adxl_hw_str,
                        "firmware_mode": f"4-CH REAL-TIME PCM DMA STREAM ({port_str} @ {baud_str}) [Type 0x05 400Hz FIFO]",
                        "is_hardware_alive": True,
                        "packets_valid": self.packets_valid,
                        "checksum_errors": self.checksum_errors,
                        "dropped_packets": self.dropped_packets,
                        "channels_active": active_channels,
                        "last_packet_time": self.last_packet_time,
                        "num_vib_last": num_vib,
                        "rms_counts": [float(r * 32768.0) for r in rms_ch],
                        "peak_counts": [int(np.max(np.abs(samples[:, ch])) * 32768.0) for ch in range(channels)]
                    })

                del buf[:total_pkt_len]

            elif pkt_type == 0x04:
                if len(buf) < HEADER_SIZE_V1:
                    break

                sync1, sync2, ptype, channels, seq, fs_val, block_frames, ax_mg, ay_mg, az_mg, pulses = struct.unpack_from(
                    HEADER_FORMAT_V1, buf, 0
                )

                # Defensive sanity check on legacy 0x04 packet bounds
                if channels != 4 or block_frames != 128 or fs_val < 1000 or fs_val > 96000:
                    del buf[:2]
                    continue

                audio_len = block_frames * channels * 2
                total_pkt_len = HEADER_SIZE_V1 + audio_len + 2
                if len(buf) < total_pkt_len:
                    break

                expected_chk = struct.unpack_from("<H", buf, HEADER_SIZE_V1 + audio_len)[0]
                hdr_bytes = bytes(buf[0 : HEADER_SIZE_V1])
                payload_bytes = bytes(buf[HEADER_SIZE_V1 : HEADER_SIZE_V1 + audio_len])

                chk = 0x55AA
                for i, b in enumerate(hdr_bytes):
                    chk ^= ((b << (i % 8)) & 0xFFFF)
                for i, b in enumerate(payload_bytes):
                    chk ^= ((b << (i % 8)) & 0xFFFF)

                if (chk & 0xFFFF) != (expected_chk & 0xFFFF):
                    self.checksum_errors += 1
                    del buf[:2]
                    continue

                parsed_count += 1
                self.packets_valid += 1
                if self.last_seq is not None:
                    expected_seq = (self.last_seq + 1) & 0xFFFF
                    if seq != expected_seq:
                        drop = (seq - expected_seq) & 0xFFFF
                        if drop < 500:
                            self.dropped_packets += drop
                self.last_seq = seq
                self.last_packet_time = time.time()

                t_pkt = self.last_packet_time
                with self.vib_ring_lock:
                    self.vib_ring_time.append(t_pkt)
                    self.vib_ring_ax.append(float(ax_mg) / 1000.0)
                    self.vib_ring_ay.append(float(ay_mg) / 1000.0)
                    self.vib_ring_az.append(float(az_mg) / 1000.0)

                latest_ax = float(ax_mg) / 1000.0
                latest_ay = float(ay_mg) / 1000.0
                latest_az = float(az_mg) / 1000.0

                samples = np.frombuffer(payload_bytes, dtype=np.int16).reshape((block_frames, channels)).astype(np.float32) / 32768.0
                rms_ch = [float(np.sqrt(np.mean(samples[:, ch].astype(np.float64)**2))) for ch in range(channels)]
                active_channels = sum(1 for r in rms_ch if r > 0.0003)

                with self.lock:
                    if samples.shape == (block_frames, self.channels):
                        self.buffer = np.roll(self.buffer, -block_frames, axis=0)
                        self.buffer[-block_frames:, :] = samples
                    self.fs = float(fs_val)

                    now = time.time()
                    dt = now - self.last_pulse_time
                    if dt >= 0.5:
                        dp = pulses - self.last_pulse_count
                        if dp >= 0 and dt > 0:
                            self.telemetry["estimated_rpm"] = (dp / dt) * 60.0
                        self.last_pulse_count = pulses
                        self.last_pulse_time = now

                    self.telemetry.update({
                        "ax_g": latest_ax,
                        "ay_g": latest_ay,
                        "az_g": latest_az,
                        "rpm_pulses": pulses,
                        "firmware_mode": f"4-CH REAL-TIME PCM DMA STREAM ({port_str} @ {baud_str}) [Type 0x04 Legacy]",
                        "is_hardware_alive": True,
                        "packets_valid": self.packets_valid,
                        "checksum_errors": self.checksum_errors,
                        "dropped_packets": self.dropped_packets,
                        "channels_active": active_channels,
                        "last_packet_time": self.last_packet_time,
                        "num_vib_last": 1,
                        "rms_counts": [float(r * 32768.0) for r in rms_ch],
                        "peak_counts": [int(np.max(np.abs(samples[:, ch])) * 32768.0) for ch in range(channels)]
                    })

                del buf[:total_pkt_len]

            else:
                # Unknown packet type or noise: advance 2 bytes past sync
                del buf[:2]
                continue

        return parsed_count

    def _worker(self):
        while self.running:
            target_port = self._find_port()
            connected = False

            for baud in self.baudrates:
                try:
                    s = serial.Serial()
                    s.port = target_port
                    s.baudrate = baud
                    s.dtr = False
                    s.rts = False
                    s.timeout = 0.25
                    s.open()
                    time.sleep(0.1)
                    s.reset_input_buffer()
                    # Trigger continuous streaming mode on ESP32
                    s.write(b"S\n")
                    s.flush()
                    connected = True
                    self.ser = s

                    with self.lock:
                        self.telemetry["port"] = target_port
                        self.telemetry["firmware_mode"] = f"CONNECTED ({target_port} @ {baud})"
                    break
                except Exception:
                    continue

            if not connected:
                with self.lock:
                    self.telemetry["firmware_mode"] = "STANDBY (ESP32 USB NOT DETECTED)"
                    self.telemetry["is_hardware_alive"] = False
                time.sleep(1.0)
                continue

            self._rx_buf.clear()
            last_rx_time = time.time()

            while self.running and self.ser and self.ser.is_open:
                try:
                    n = self.ser.in_waiting
                    if n > 0:
                        chunk = self.ser.read(n)
                        last_rx_time = time.time()
                        self._parse_incoming_bytes(chunk, port_str=target_port, baud_str=self.ser.baudrate)
                    else:
                        if time.time() - last_rx_time > 3.0:
                            self.ser.write(b"S\n")
                            last_rx_time = time.time()
                        time.sleep(0.005)

                except Exception:
                    break

            try:
                if self.ser: self.ser.close()
            except Exception: pass
            time.sleep(0.5)

    def get_frame(self) -> np.ndarray:
        with self.lock:
            if not self.telemetry["is_hardware_alive"]:
                # Hardware disconnected or standby: Return silent zeros.
                # NEVER invent synthetic moving audio in ESP32 hardware mode!
                return np.zeros((self.frame_len, self.channels), dtype=np.float32)
            return self.buffer.copy()

    def get_fs(self) -> float:
        return self.fs

    def get_channels(self) -> int:
        return self.channels

    def get_multimodal_telemetry(self) -> Dict[str, object]:
        with self.lock:
            return self.telemetry.copy()


# Backward compatibility alias
SerialAudioSource = ESP32MultimodalSource


class Synthetic4ChSource(AudioSourceBase):
    """Simulates a 4-channel orbiting acoustic emitter with 3-axis vibration and shaft tachometer."""

    def __init__(self, fs: float = 16000.0):
        self.fs = fs
        self.channels = 4
        self.frame_len = 512
        self.t_phase = 0.0
        self.pulses = 120

    def start(self): pass
    def stop(self): pass

    def get_frame(self) -> np.ndarray:
        t = np.arange(self.frame_len) / self.fs + self.t_phase
        self.t_phase += self.frame_len / self.fs

        # Move source sinusoidally across [-40 deg, +40 deg]
        angle_deg = 35.0 * np.sin(2.0 * np.pi * 0.28 * self.t_phase)
        angle_rad = np.deg2rad(angle_deg)
        d_pitch = 0.02032
        mic_x = np.array([-1.5, -0.5, +0.5, +1.5]) * d_pitch

        # Multi-harmonic rotating machinery audio signature with exact continuous sub-sample delays
        out = np.zeros((self.frame_len, 4), dtype=np.float32)
        for i in range(4):
            delay_s = (mic_x[i] * np.sin(angle_rad)) / SPEED_OF_SOUND
            t_i = t + delay_s
            sig_i = (
                0.60 * np.sin(2 * np.pi * 1200.0 * t_i)
                + 0.25 * np.sin(2 * np.pi * 2400.0 * t_i)
                + 0.10 * np.sin(2 * np.pi * 3600.0 * t_i)
                + 0.03 * np.random.randn(self.frame_len)
            ).astype(np.float32)
            out[:, i] = sig_i

        self.pulses += int(np.random.randint(1, 4))
        return out

    def get_fs(self) -> float: return self.fs
    def get_channels(self) -> int: return self.channels
    def get_multimodal_telemetry(self) -> Dict[str, object]:
        vib_x = 0.12 * math.sin(2.0 * math.pi * 18.0 * self.t_phase)
        vib_y = 0.15 * math.cos(2.0 * math.pi * 18.0 * self.t_phase)
        vib_z = -0.82 + 0.08 * math.sin(2.0 * math.pi * 36.0 * self.t_phase)
        rpm = 1080.0 + 20.0 * math.sin(self.t_phase)

        rms_counts = [
            float(np.sqrt(np.mean(self.get_frame()[:, i]**2)) * 12000.0) for i in range(4)
        ]

        return {
            "ax_g": vib_x, "ay_g": vib_y, "az_g": vib_z,
            "rpm_pulses": self.pulses,
            "estimated_rpm": rpm,
            "firmware_mode": "SYNTHETIC 4-CH ARRAY SIMULATION",
            "rms_counts": rms_counts,
            "peak_counts": [int(v * 1.45) for v in rms_counts],
            "is_hardware_alive": True
        }

    def get_vibration_history(self, max_samples: int = 512) -> Tuple[np.ndarray, np.ndarray, np.ndarray, np.ndarray]:
        t_now = time.time()
        fs_sim = 400.0
        n_samples = min(max_samples, 256)
        t_arr = np.linspace(t_now - n_samples / fs_sim, t_now, n_samples)
        vib_x = (0.12 * np.sin(2.0 * np.pi * 18.0 * t_arr)).astype(np.float32)
        vib_y = (0.15 * np.cos(2.0 * np.pi * 18.0 * t_arr)).astype(np.float32)
        vib_z = (-0.82 + 0.08 * np.sin(2.0 * np.pi * 36.0 * t_arr)).astype(np.float32)
        return t_arr, vib_x, vib_y, vib_z


class LaptopAudioSource(AudioSourceBase):
    """Ingests audio from laptop internal microphone array (2-channel or 4-channel)."""

    def __init__(self):
        self.device_index, self.channels = self._find_device()
        d = sd.query_devices(self.device_index)
        self.fs = float(d.get("default_samplerate", 44100.0))
        self.frame_len = int(0.040 * self.fs)
        self.buffer = np.zeros((self.frame_len, 4), dtype=np.float32)
        self.lock = threading.Lock()
        self.stream: Optional[sd.InputStream] = None

    def _find_device(self) -> Tuple[int, int]:
        devices = sd.query_devices()
        # Look for 4-channel array first (e.g. Intel Smart Sound directsound)
        for i, d in enumerate(devices):
            name = d.get("name", "").lower()
            ch = int(d.get("max_input_channels", 0))
            if ch >= 4 and any(k in name for k in ["array", "intel", "smart sound"]):
                return i, 4
        # Fallback to stereo array
        for i, d in enumerate(devices):
            name = d.get("name", "").lower()
            ch = int(d.get("max_input_channels", 0))
            if ch >= 2 and any(k in name for k in ["array", "intel", "realtek"]):
                return i, 2
        return int(sd.default.device[0]), 2

    def _callback(self, indata, frames, time_info, status):
        with self.lock:
            n = min(frames, self.frame_len)
            if self.channels >= 4:
                self.buffer[:n, :4] = indata[:n, :4]
            else:
                self.buffer[:n, 0] = indata[:n, 0]
                self.buffer[:n, 1] = indata[:n, 1]
                self.buffer[:n, 2:] = 0.0

    def start(self):
        try:
            self.stream = sd.InputStream(
                device=self.device_index,
                samplerate=self.fs,
                channels=self.channels,
                dtype="float32",
                blocksize=self.frame_len,
                callback=self._callback
            )
            self.stream.start()
        except Exception as exc:
            print(f"[-] Sounddevice Start Warning: {exc}")

    def stop(self):
        if self.stream:
            try:
                self.stream.stop()
                self.stream.close()
            except Exception: pass
            self.stream = None

    def get_frame(self) -> np.ndarray:
        with self.lock:
            return self.buffer.copy()

    def get_fs(self) -> float: return self.fs
    def get_channels(self) -> int: return self.channels
    def get_multimodal_telemetry(self) -> Dict[str, object]:
        return {
            "ax_g": 0.0, "ay_g": 0.0, "az_g": -1.0,
            "rpm_pulses": 0, "estimated_rpm": 0.0,
            "firmware_mode": f"LAPTOP INTERNAL MIC ({self.channels}-CH)",
            "rms_counts": [float(np.sqrt(np.mean(self.buffer[:, i]**2))*10000) for i in range(4)],
            "peak_counts": [1000, 1000, 1000, 1000],
            "is_hardware_alive": True
        }
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
