yoganandasp15/Spatial-accoustic-project/(commit log)

2026-11-07 feat(minor-project): complete Stages 1-4, simulation suite, firmware, live radar HUD, and presentation deck
    [data_integrity.csv, stage2_localization_benchmarks.csv, stage2_snr_robustness.csv, tachometer_rpm_estimates.csv, vibration_features.csv, window_stability_summary.csv]
2026-11-07 fix(audit): reconcile peer review feedback from ChatGPT across firmware, GUI, and docs
    [ESP32_Spatial_Acoustic_Radar_Firmware.ino, spatial_acoustic_radar_pro.py]
2026-11-07 feat(multi-agent): [Agent 1fbd76d3] [2026-11-07 20:22] establish multi-agent synchronization ledger, git pull invariant, and attribution protocol
2026-11-07 feat(pipeline): [Agent df1dc2a8] [2026-11-07 20:28] Add Dual-I2S phase calibration, angular order tracking, offline multimodal evaluator, and automated test suite
    [multimodal_4mic_vibration.csv]
2026-11-07 fix(dsp): [Agent 1fbd76d3] [2026-11-07 22:26] resolve ChatGPT audit: vibration order tracking, per-axis gravity decoupling, checksum validation, and script paths
    [stage2_localization_benchmarks.csv, stage2_snr_robustness.csv]
2026-11-07 docs(sync): [Agent 1fbd76d3] [2026-11-07 22:27] record commit SHA 02ea6dc in synchronization ledger
2026-11-07 fix(dsp): [Agent e44d74a8] [2026-11-07 23:42] M1: Harmonize phase calibration, fractional delay, N-1 order intervals, and vibration ring buffer
    [calibrate_i2s_phase.py, offline_multimodal_evaluator.py, spatial_acoustic_radar_pro.py]
2026-11-07 docs(sync): [Agent 7d34e526] [2026-11-08 00:06] Record commit SHA b458d9a in synchronization ledger
2026-11-07 fix(dsp): [Agent 22c4b5f4] [2026-11-08 00:21] M1: remediate phase compensation delay sign, tachometer noise gate, and test alignment
    [calibrate_i2s_phase.py, offline_multimodal_evaluator.py, spatial_acoustic_radar_pro.py, test_multimodal_pipeline.py]
2026-11-07 docs(sync): [Agent 22c4b5f4] [2026-11-08 00:22] update synchronization ledger commit sha
2026-11-07 feat(firmware): [Agent 62ceb4f4] [2026-11-08 00:53] M2: implement ADXL345 400Hz FIFO streaming, type 0x05 packet protocol, and 1.152M baud receiver
2026-11-07 docs(sync): [Agent 62ceb4f4] [2026-11-08 00:54] record commit SHA f86a486 in synchronization ledger
2026-11-07 docs(sync): [Agent 48602294] [2026-11-08 01:11] record commit SHA ec5aa14 in synchronization ledger
2026-11-07 fix(receiver): [Agent 92ff83d8] [2026-11-08 01:26] M2: remediate receiver header validation, defensive array assignment, and monotonic timestamps
    [spatial_acoustic_radar_pro.py, test_m2_stress_adversarial.py]
2026-11-07 docs(sync): [Agent 92ff83d8] [2026-11-08 01:27] record commit SHA ac2b748 in synchronization ledger
2026-11-07 fix(receiver): [Agent 18dc781e] [2026-11-08 01:45] M2: fix vibration timestamp monotonicity for arbitrary packet batches
    [spatial_acoustic_radar_pro.py, test_m2_stress_adversarial.py]
2026-11-07 docs(sync): [Agent 18dc781e] [2026-11-08 01:46] record commit SHA 5d88f10 in synchronization ledger
2026-11-07 docs(sync): [Agent c1d06fc5] [2026-11-08 02:10] record commit SHA 645b9ac in synchronization ledger
2026-11-07 docs(sync): [Agent 193d24c3] [2026-11-08 02:20] record commit SHA 842ffa7 in synchronization ledger
2026-11-07 docs(sync): [Agent 3515e560] [2026-11-08 02:41] record commit SHA f3e100c in synchronization ledger
2026-11-08 fix(radar): [Agent 1fbd76d3] [2026-11-08 10:30] resolve false direction in silence, VAD noise creep, and desktop launcher path
    [spatial_acoustic_radar_pro.py, test_noise_gating_regression.py]
2026-11-08 fix(multimodal): [Agent 1fbd76d3] [2026-11-08 10:45] resolve audit findings across DSP, firmware, evaluator, and documentation
    [ESP32_Spatial_Acoustic_Radar_Firmware.ino, offline_multimodal_evaluator.py, spatial_acoustic_radar_pro.py, stage2_acoustic_localization.py]
2026-11-08 fix(radar,dsp,firmware): [Agent 1fbd76d3] [2026-11-08 11:25] Fix GUI deque exception, Parseval velocity RMS, spatial coherence noise gating, and tach debounce
    [ESP32_Spatial_Acoustic_Radar_Firmware.ino, spatial_acoustic_radar_pro.py, test_noise_gating_regression.py]
2026-11-08 docs(sync): [Agent 1fbd76d3] [2026-11-08 11:26] Record cbf01be commit SHA in sync ledger
2026-11-08 fix(hardware,serial): [Agent 1fbd76d3] [2026-11-08 11:48] Synchronize dual-I2S DMA and configure 921600 baud for physical COM8 streaming
    [ESP32_Spatial_Acoustic_Radar_Firmware.ino, multimodal_hardware_diag.ino, spatial_acoustic_radar_pro.py]
2026-11-08 docs(sync): [Agent 1fbd76d3] [2026-11-08 11:49] Record 33a9d3c commit SHA in sync ledger
2026-11-08 fix(radar,dsp): [Agent 1fbd76d3] [2026-11-08 12:12] Restore continuous acoustic radar needles and repair GCC-PHAT peak prominence
    [spatial_acoustic_radar_pro.py]
2026-11-08 docs(sync): [Agent 1fbd76d3] [2026-11-08 12:13] Record 3e2dc0d commit SHA in sync ledger
2026-11-08 fix(firmware,adxl345): [Agent 1fbd76d3] [2026-11-08 12:25] Add dual I2C address auto-probing for ADXL345 and verify physical 400Hz FIFO streaming
    [ESP32_Spatial_Acoustic_Radar_Firmware.ino]
2026-11-08 docs(sync): [Agent 1fbd76d3] [2026-11-08 12:26] Record 9d7b535 commit SHA in sync ledger
2026-11-09 feat(minor-project): [Agent 1fbd76d3] [2026-11-09 12:00] Add 1-click physical motor suite, launcher batch files, disturbance rejection rule, and academic report
    [motor_defective_run.csv, motor_defective_run_meta.json, motor_disturbance_run.csv, motor_disturbance_run_meta.json, motor_experiment_summary.json, motor_healthy_run.csv, motor_healthy_run_meta.json]
2026-11-09 docs(sync): [Agent 1fbd76d3] [2026-11-09 12:01] Record 77fac63 commit SHA in sync ledger
2026-11-09 feat(gui,motor): [Agent 1fbd76d3] [2026-11-09 12:35] Elevate DC motor vibration scope and order tracking widgets to first-class GUI status
    [spatial_acoustic_radar_pro.py]
2026-11-09 docs(sync): [Agent 1fbd76d3] [2026-11-09 12:35] Record af0d1f1 commit SHA in sync ledger
2026-11-09 feat(firmware,tools,gui): [Agent 1fbd76d3] [2026-11-09 13:25] Eliminate fabricated sensor fallbacks, update tachometer edge, format HUD without text clipping, and polish batch suite
    [motor_defective_run.csv, motor_defective_run_meta.json, motor_disturbance_run.csv, motor_disturbance_run_meta.json, motor_experiment_summary.json, motor_healthy_run.csv, motor_healthy_run_meta.json]
2026-11-09 fix(firmware,dsp,tools,docs): [Agent 1fbd76d3] [2026-11-09 17:15] Correct I2S stereo channel unpacking, add sensitivity calibration branch, repair disturbance WAV lookup, and reconcile documentation
    [ESP32_Spatial_Acoustic_Radar_Firmware.ino, compare_motor_experiments.py, spatial_acoustic_radar_pro.py]
2026-11-09 fix(dsp,gui,tools,docs): [Agent 1fbd76d3] [2026-11-09 17:55] Complete sensitivity calibration branch, refine acoustic backprojection labels, add disturbance WAV warning, and reconcile documentation
    [compare_motor_experiments.py, spatial_acoustic_radar_pro.py]
2026-11-09 fix(dsp,radar,gui): [Agent 1fbd76d3] [2026-11-09 19:00] Implement adaptive noise floor gate, sensitivity-scaled GCC-PHAT pre-gating, and expand acoustic bandwidth to 45 Hz
    [spatial_acoustic_radar_pro.py]
2026-11-09 docs(sync): [Agent 1fbd76d3] [2026-11-09 19:01] Record 43a2771 commit SHA in sync ledger
2026-11-09 feat(gui,launchers): [Agent 1fbd76d3] [2026-11-09 20:52] Implement AI Studio 7-point UI collision elimination, Minor Project Vision cards, and upgraded console launchers
    [fix_radar_ui.py, spatial_acoustic_radar_pro.py]
2026-11-09 docs(sync): [Agent 1fbd76d3] [2026-11-09 20:52] Record 6f16205 commit SHA in sync ledger
2026-11-09 fix(dataset,protocol): [Agent 1fbd76d3] [2026-11-09 22:12] Reconcile Phase 1 data integrity, monotonic timing, +/-2g ADXL range, and 2x2 matrix launchers
    [record_motor_experiment.py, test_dataset_recording_pipeline.py, validate_dataset.py]
2026-11-09 fix(tools,recorder): [Agent 1fbd76d3] [2026-11-09 22:30] Fix cumulative tachometer baseline, non-zero interrupted exit code, header contract validation, and sync Desktop launchers
    [record_motor_experiment.py, test_dataset_recording_pipeline.py, validate_dataset.py]
2026-11-09 docs(sync): [Agent 1fbd76d3] [2026-11-09 22:31] Record 4969251 commit SHA in sync ledger
2026-11-11 fix(firmware): [Agent baa616fb] [2026-11-11 16:15] optimize tachometer ISR debounce to 10us for high-RPM motor tracking
    [ESP32_Spatial_Acoustic_Radar_Firmware.ino]
2026-11-11 feat(launchers): [Agent baa616fb] [2026-11-11 17:06] universal repository and esp32 port auto-detection across all launchers and tools
2026-11-12 feat(ui): [Agent fe2e9d97] [2026-11-12 14:41] Redesign right-side Col 3 UI (Shaft Speed, Harmonic Orders, Motor Diagnostics) and default COM8
    [motor_defective_run.csv, motor_defective_run_meta.json, motor_healthy_run.csv, motor_healthy_run_meta.json, packet_log.csv, vibration.csv]
2026-11-12 fix(radar): [Agent baa616fb] [2026-11-12 16:11] Remove synthetic RPM baseline; enforce strict 0.0 RPM idle state on startup
    [diagnostic_hud.py, spatial_acoustic_radar_pro.py]
2026-11-12 fix(radar): [Agent fe2e9d97] [2026-11-12 16:31] Fix keyboard input - clear matplotlib keymaps stealing b/g/k/p/r/s/q + force Qt canvas focus + default port COM8
    [spatial_acoustic_radar_pro.py]
